Breschdling/HEMAC/MCU/HEMAC_MCU_BOM.ods

Id | Designator | Quantity | Designation | Package
3 | J201 | 1 | Connector angled, maleDIN41612_2x32_B | DIN41612_B_2x32_Horizontal
4 | M101 | 1 | Eurocard_Handle | EuroCard_Handle
5 | U601,U303 | 2 | PCA9515 | SOIC-8_3.9x4.9mm_P1.27mm
6 | D302,D303,D301 | 3 | LED | LED_D3.0mm
7 | X701 | 1 | Raspberry PI model 4 | raspberrypi4
8 | FB101,FB102 | 2 | Ferrite bead 100R, 1210, SMD | FB_1210_3225Metric_Pad1.42x2.65mm_HandSolder
9 | L201,L701 | 2 | Inductor 120uH_3A THT 16mm | 16mm_Radial
10 | SW701 | 1 | Tactile switch_90_Degeree | SW_Tactile_SPST_Angled_PTS645Vx58-2LFS
11 | U301 | 1 | Logic IC 74HC14D SOIC 14 | SOIC-14_3.9x8.7mm_P1.27mm
12 | U401,U501,U502 | 3 | Logic IC 74HC245 SOIC 20W | SOIC-20W_7.5x12.8mm_P1.27mm
13 | C101 | 1 | Capacitor 1nF 1kV 1210, SMD | C_1210
14 | C201,C207,C301,C302,C303,C401,C501,C502,C601,C706,C712 | 11 | Capacitor 100nF 50V 0805 SMD | C_0805
15 | C202,C203,C204,C205,C206,C208,C209,C210,C211,C212,C701,C702,C703,C704,C705,C707,C708,C709,C710,C711 | 20 | Capacitor 10uF 16V 0805 SMD | C_0805
16 | Q601 | 1 | Mosfet 2N7002, SOT-23 SMD | SOT-23
17 | R101,R102,R701,R702,R703,R704 | 6 | Resistor 1210 0R | R_1210
18 | R103 | 1 | Resistor 1210 1M | R_1210
19 | R201,R202,R203,R204,R205,R206,R207,R208,R209,R210,R211,R212,R213,R214,R215,R216,R217,R218,R219,R220,R221,R222,R223,R224,R225,R226,R227,R228,R229,R230,R231,R232,R233,R234,R235,R236,R237,R604,R705 | 39 | Resistor 0805 1% 100R | R_0805
20 | R301,R302,R306 | 3 | Resistor 0805 1% 0R | R_0805
21 | R303,R304,R305 | 3 | Resistor 0805 1% 220R | R_0805
22 | R307,R308,R309,R310 | 4 | Resistor 0805 1% 3k9 | R_0805
23 | R401,R402,R501,R502,R503,R504 | 6 | Resistor 0805 1% 1k | R_0805
24 | R601,R602,R606,R607 | 4 | Resistor 0805 1% 1k8 | R_0805
25 | R603,R605 | 2 | Resistor 0805 1% 4k7 | R_0805
26 | U302 | 1 | EEPROM IC CAT24C32 SOIC 8 | SOIC-8_3.9x4.9mm_P1.27mm
