Breschdling/HEMAC/MCU/Design/HEMAC_MCU_PCB_0.1.pdf

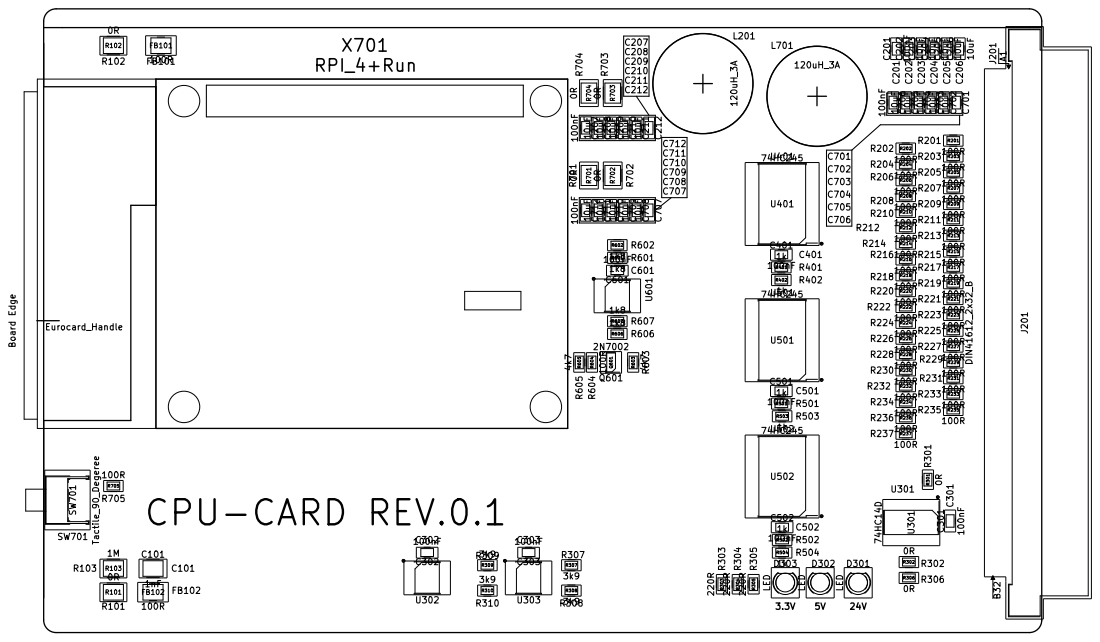
[picture p1: page 1]
