Breschdling/HEMAC/Power/Design/HEMAC_POWER_SCH_0.1.pdf

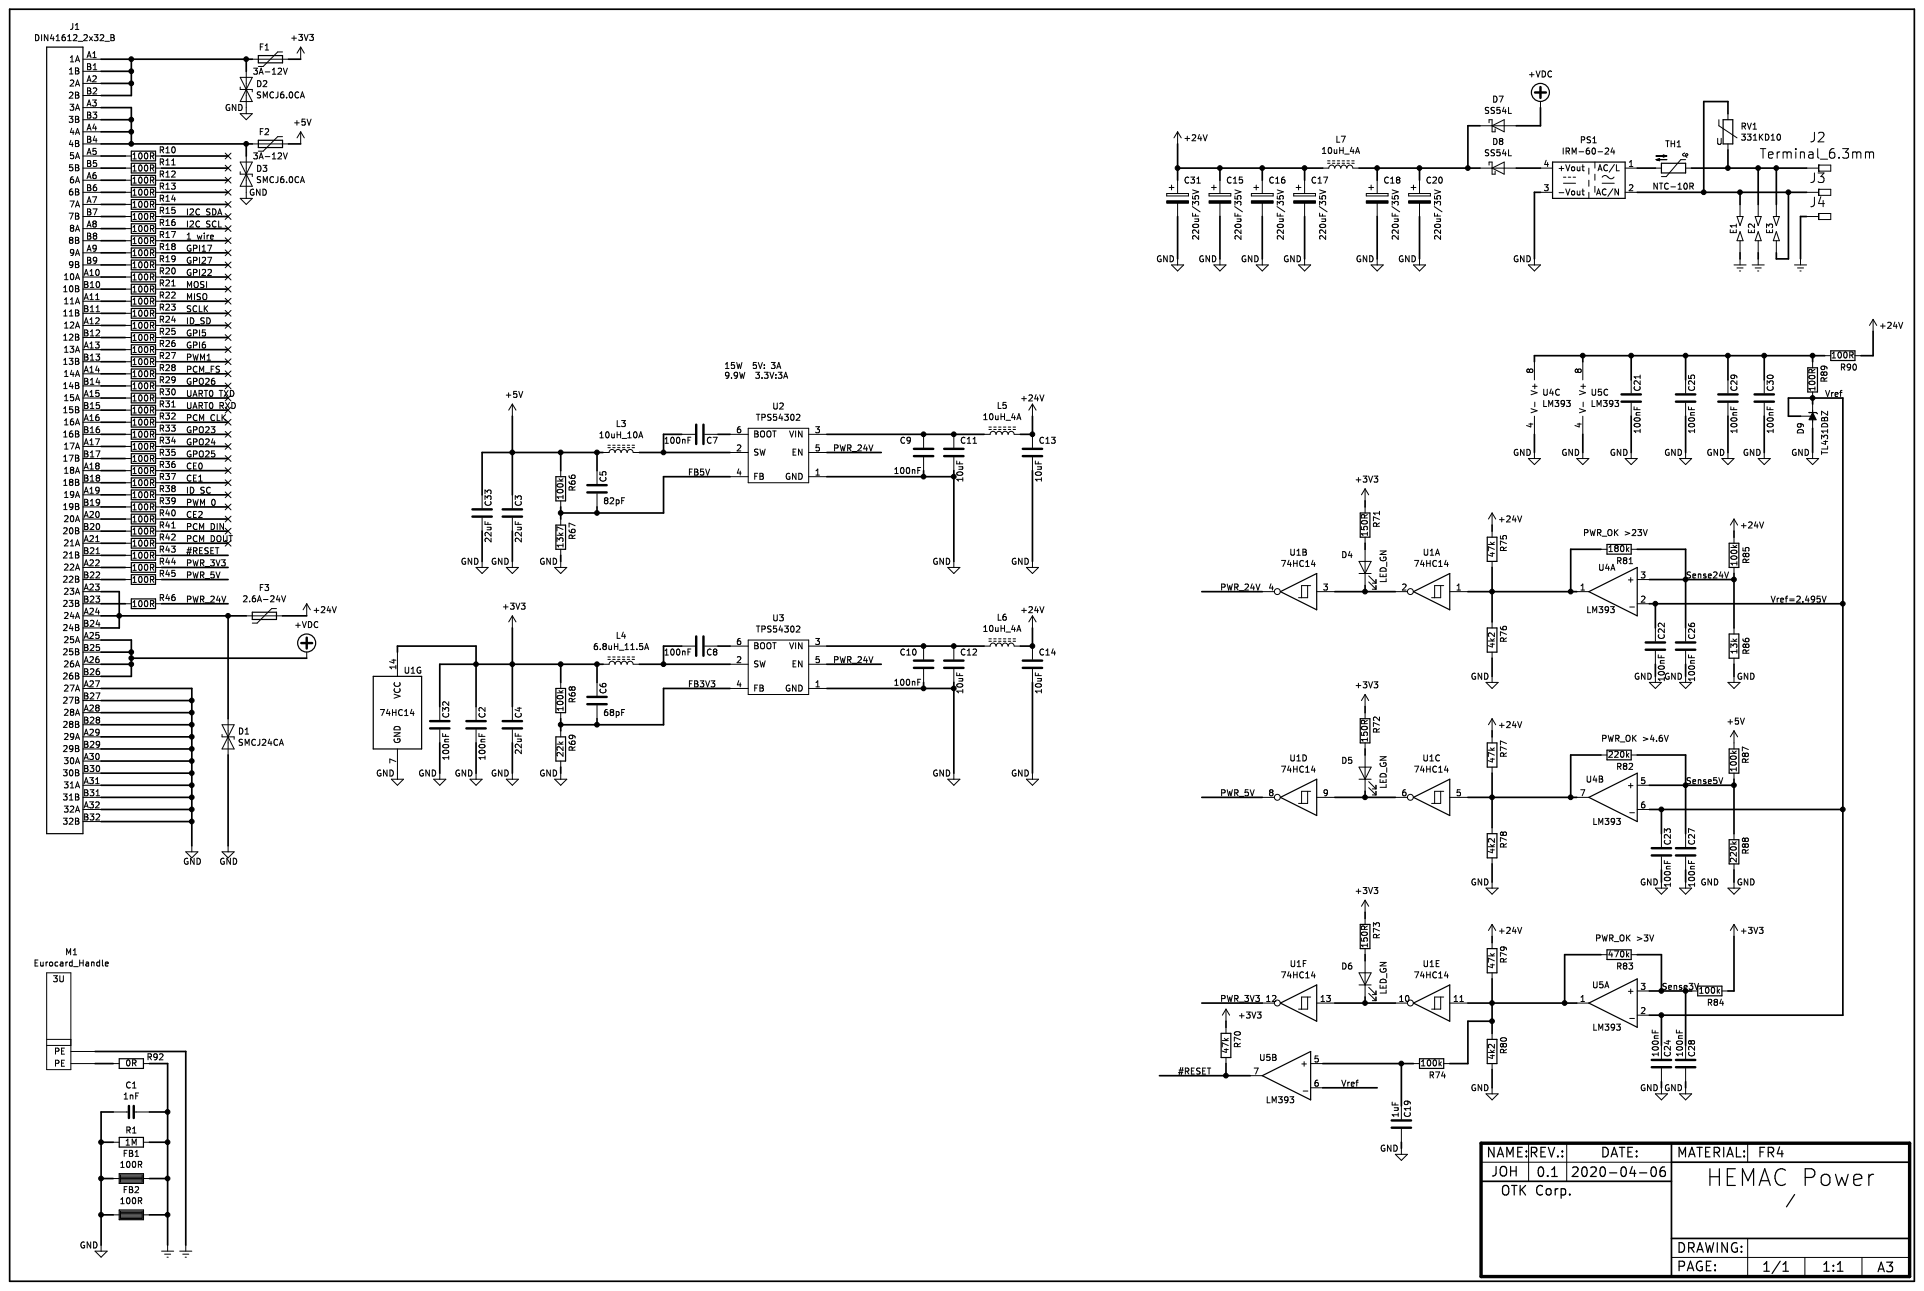
[picture p9: page 1]
