Breschdling/HEMAC/Power/Gerber/PrintPlacement.pdf

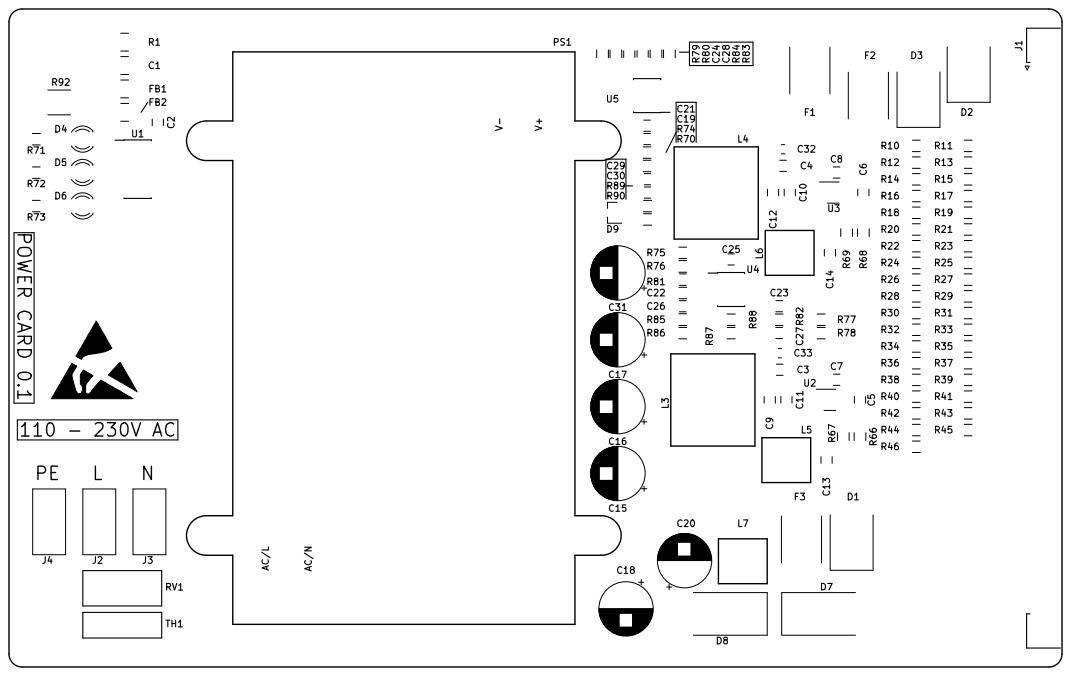
[picture p10: page 1]
