Breschdling/HEMAC/Display/SCH-HEMAC-DISP.pdf

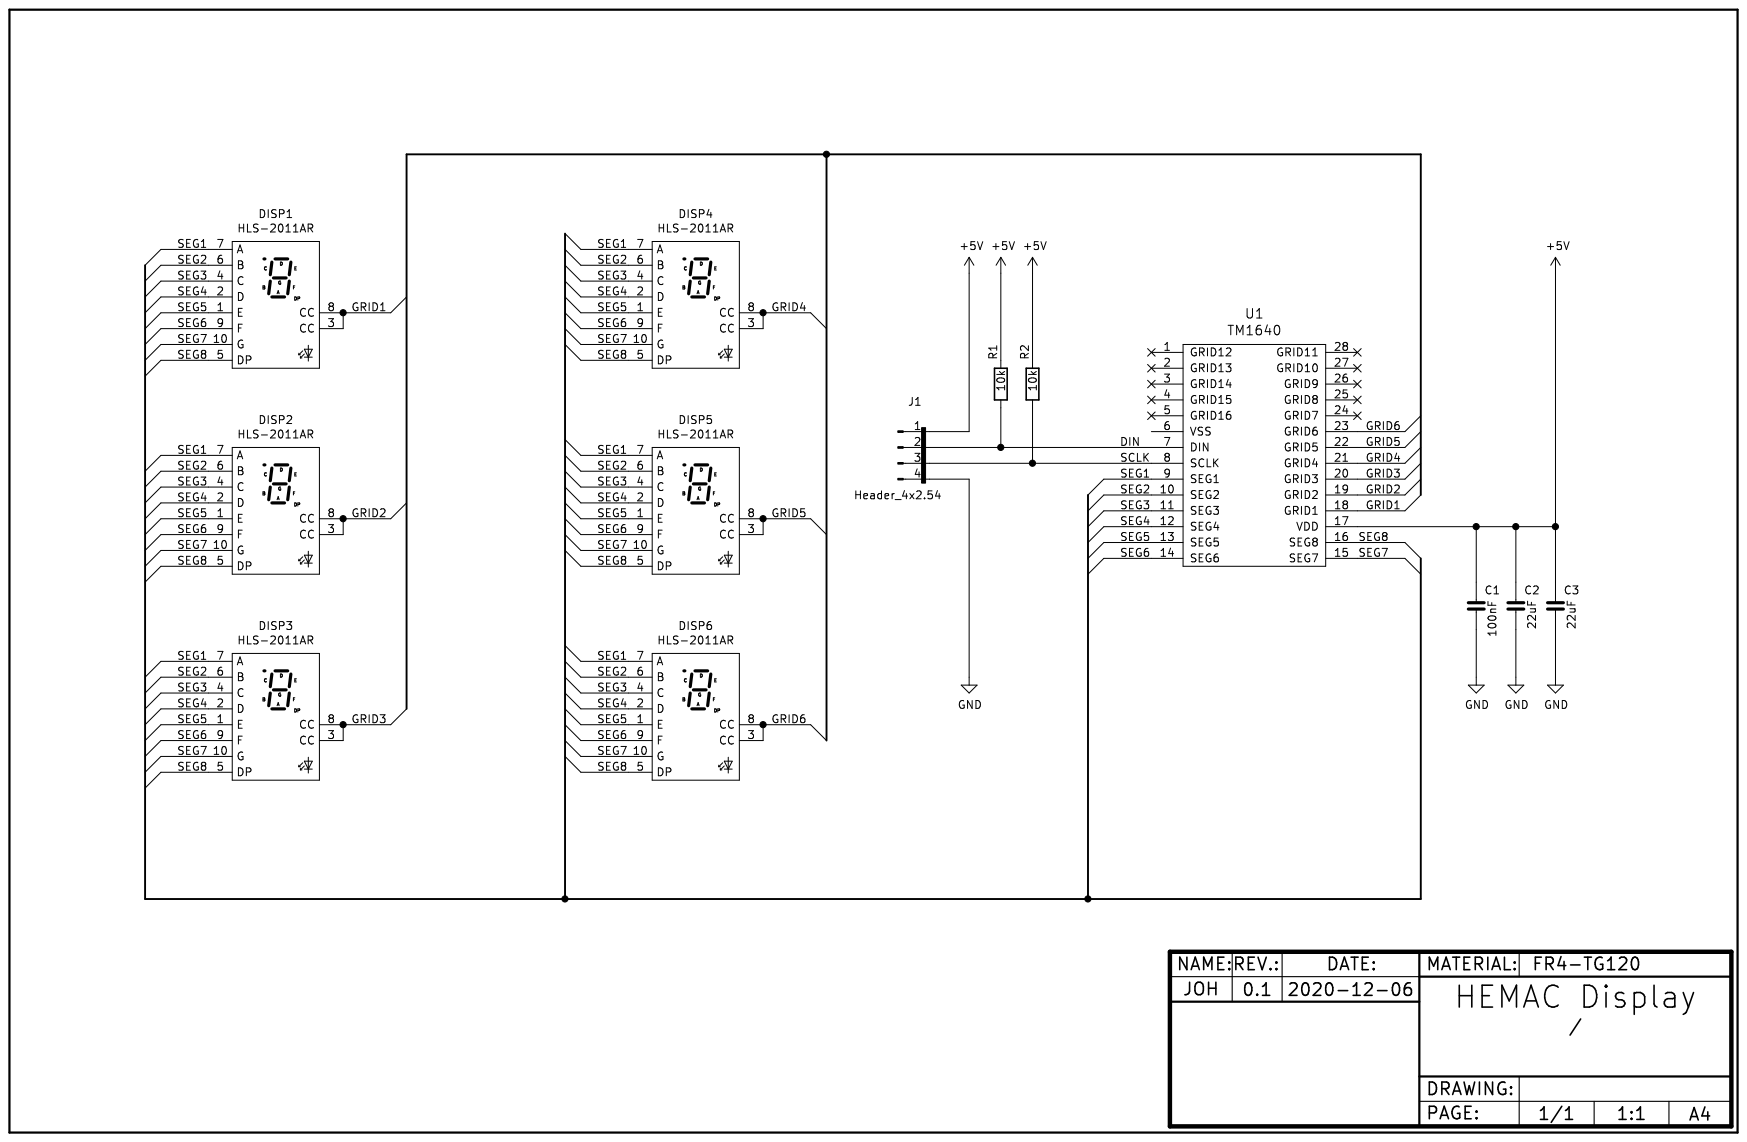
[picture p11: page 1]
