Breschdling/HEMAC/(list of files, drawings)

Other design files:
Display/HEMAC_DISP2.dsn
MCU/HEMAC_MCU.dsn
MCU/HEMAC_MCU_design1.dsn
MCU/HEMAC_MCU_design2.dsn
MCU/HEMAC_MCU_design3.dsn
Power/HEMAC_POWER.dsn
