Breschdling/HEMAC/Display/HEMAC_DISP.kicad_pcb

## KiCad design Display/HEMAC_DISP.kicad_pcb (2023-01-20)

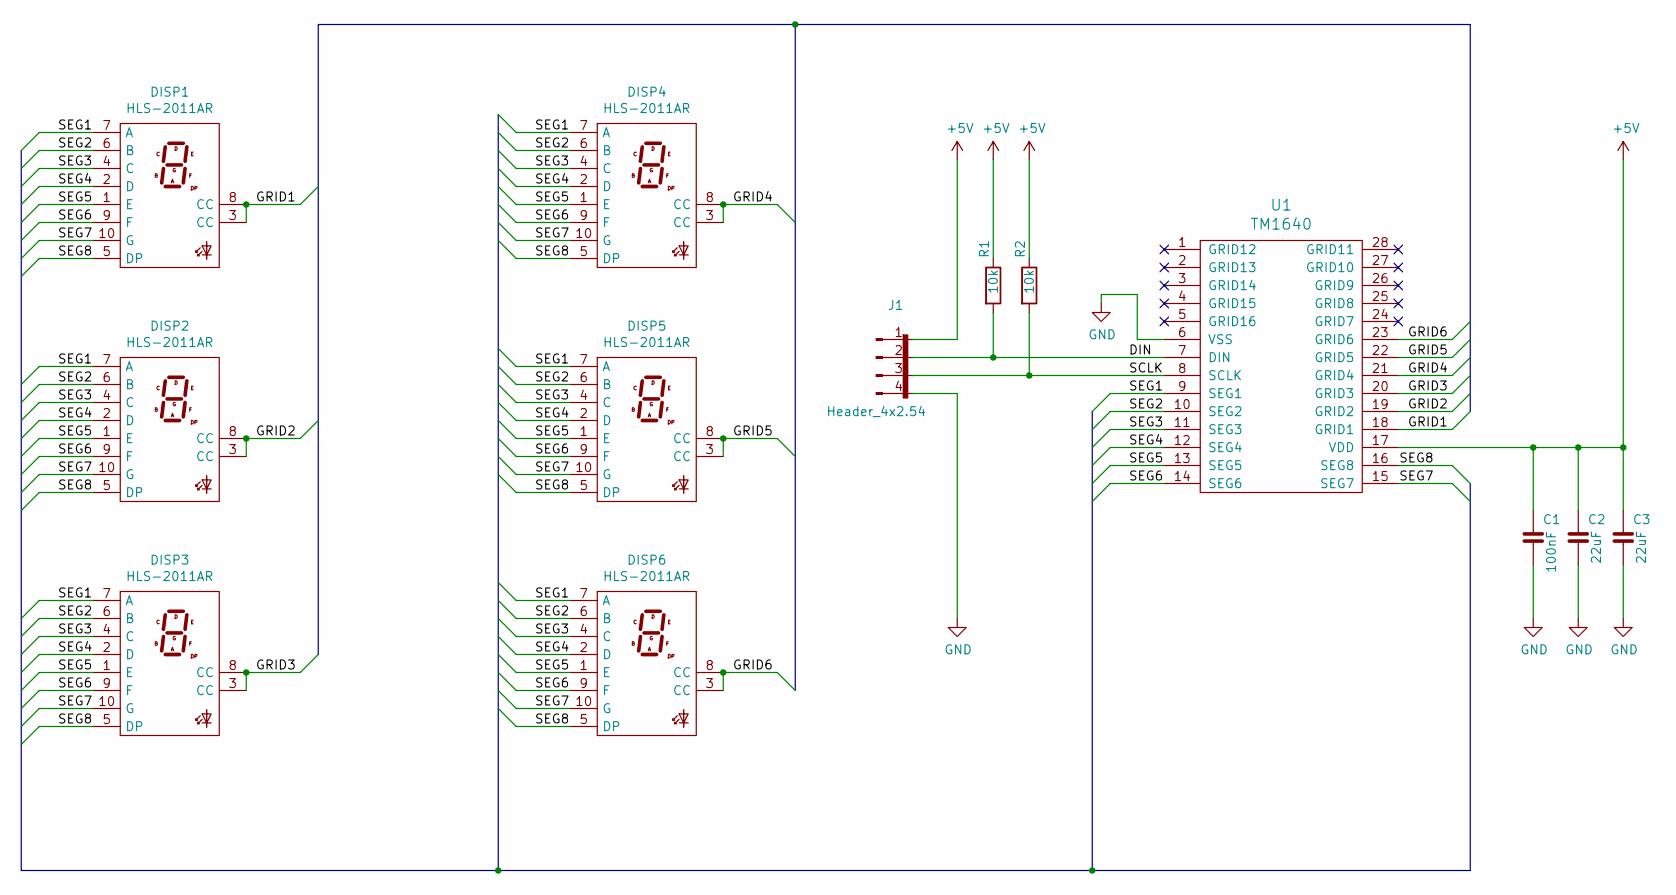
[picture p12: schematic HEMAC_DISP.sch, HEMAC Display]

Parts:
C1: 100nF; C_0805
C2, C3: 22uF; C_0805
DISP1, DISP2, DISP3, DISP4, DISP5, DISP6: HLS-2011AR; HLS-2011_Via
J1: Header_4x2.54; PinHeader_1x04_P2.54mm_Vertical
R1, R2: 10k; R_0805
U1: TM1640; SOIC28P127_1740X1015X255L60X40M

Connections:
+5V: C1.1, C2.1, C3.1, J1.1, R1.1, R2.1, U1.17 (VDD)
/DIN: J1.2, R1.2, U1.7 (DIN)
/GRID1: DISP1.3 (CC), DISP1.8 (CC), U1.18 (GRID1)
/GRID2: DISP2.3 (CC), DISP2.8 (CC), U1.19 (GRID2)
/GRID3: DISP3.3 (CC), DISP3.8 (CC), U1.20 (GRID3)
/GRID4: DISP4.3 (CC), DISP4.8 (CC), U1.21 (GRID4)
/GRID5: DISP5.3 (CC), DISP5.8 (CC), U1.22 (GRID5)
/GRID6: DISP6.3 (CC), DISP6.8 (CC), U1.23 (GRID6)
/SCLK: J1.3, R2.2, U1.8 (SCLK)
/SEG1: DISP1.7 (A), DISP2.7 (A), DISP3.7 (A), DISP4.7 (A), DISP5.7 (A), DISP6.7 (A), U1.9 (SEG1)
/SEG2: DISP1.6 (B), DISP2.6 (B), DISP3.6 (B), DISP4.6 (B), DISP5.6 (B), DISP6.6 (B), U1.10 (SEG2)
/SEG3: DISP1.4 (C), DISP2.4 (C), DISP3.4 (C), DISP4.4 (C), DISP5.4 (C), DISP6.4 (C), U1.11 (SEG3)
/SEG4: DISP1.2 (D), DISP2.2 (D), DISP3.2 (D), DISP4.2 (D), DISP5.2 (D), DISP6.2 (D), U1.12 (SEG4)
/SEG5: DISP1.1 (E), DISP2.1 (E), DISP3.1 (E), DISP4.1 (E), DISP5.1 (E), DISP6.1 (E), U1.13 (SEG5)
/SEG6: DISP1.9 (F), DISP2.9 (F), DISP3.9 (F), DISP4.9 (F), DISP5.9 (F), DISP6.9 (F), U1.14 (SEG6)
/SEG7: DISP1.10 (G), DISP2.10 (G), DISP3.10 (G), DISP4.10 (G), DISP5.10 (G), DISP6.10 (G), U1.15 (SEG7)
/SEG8: DISP1.5 (DP), DISP2.5 (DP), DISP3.5 (DP), DISP4.5 (DP), DISP5.5 (DP), DISP6.5 (DP), U1.16 (SEG8)
GND: C1.2, C2.2, C3.2, J1.4, U1.6 (VSS)

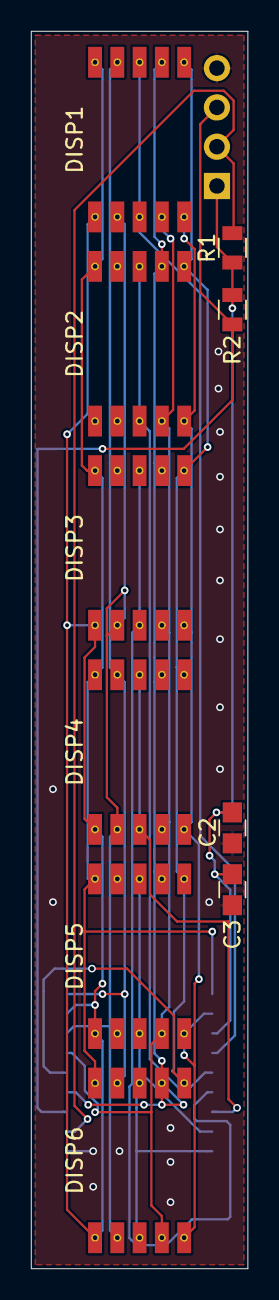
[picture p13: board HEMAC_DISP.kicad_pcb from above]

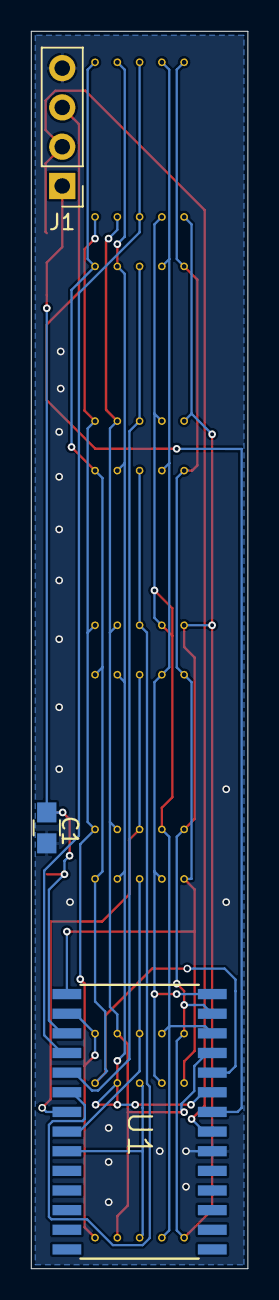
[picture p14: board HEMAC_DISP.kicad_pcb from below]

Board: 2 copper layers, 14.0 x 80.0 mm, 13 parts (3 on the bottom side), 18 nets.
