Breschdling/HEMAC/Backplane/HEMAC_Backplane.kicad_pcb

## KiCad design Backplane/HEMAC_Backplane.kicad_pcb (2023-01-20)

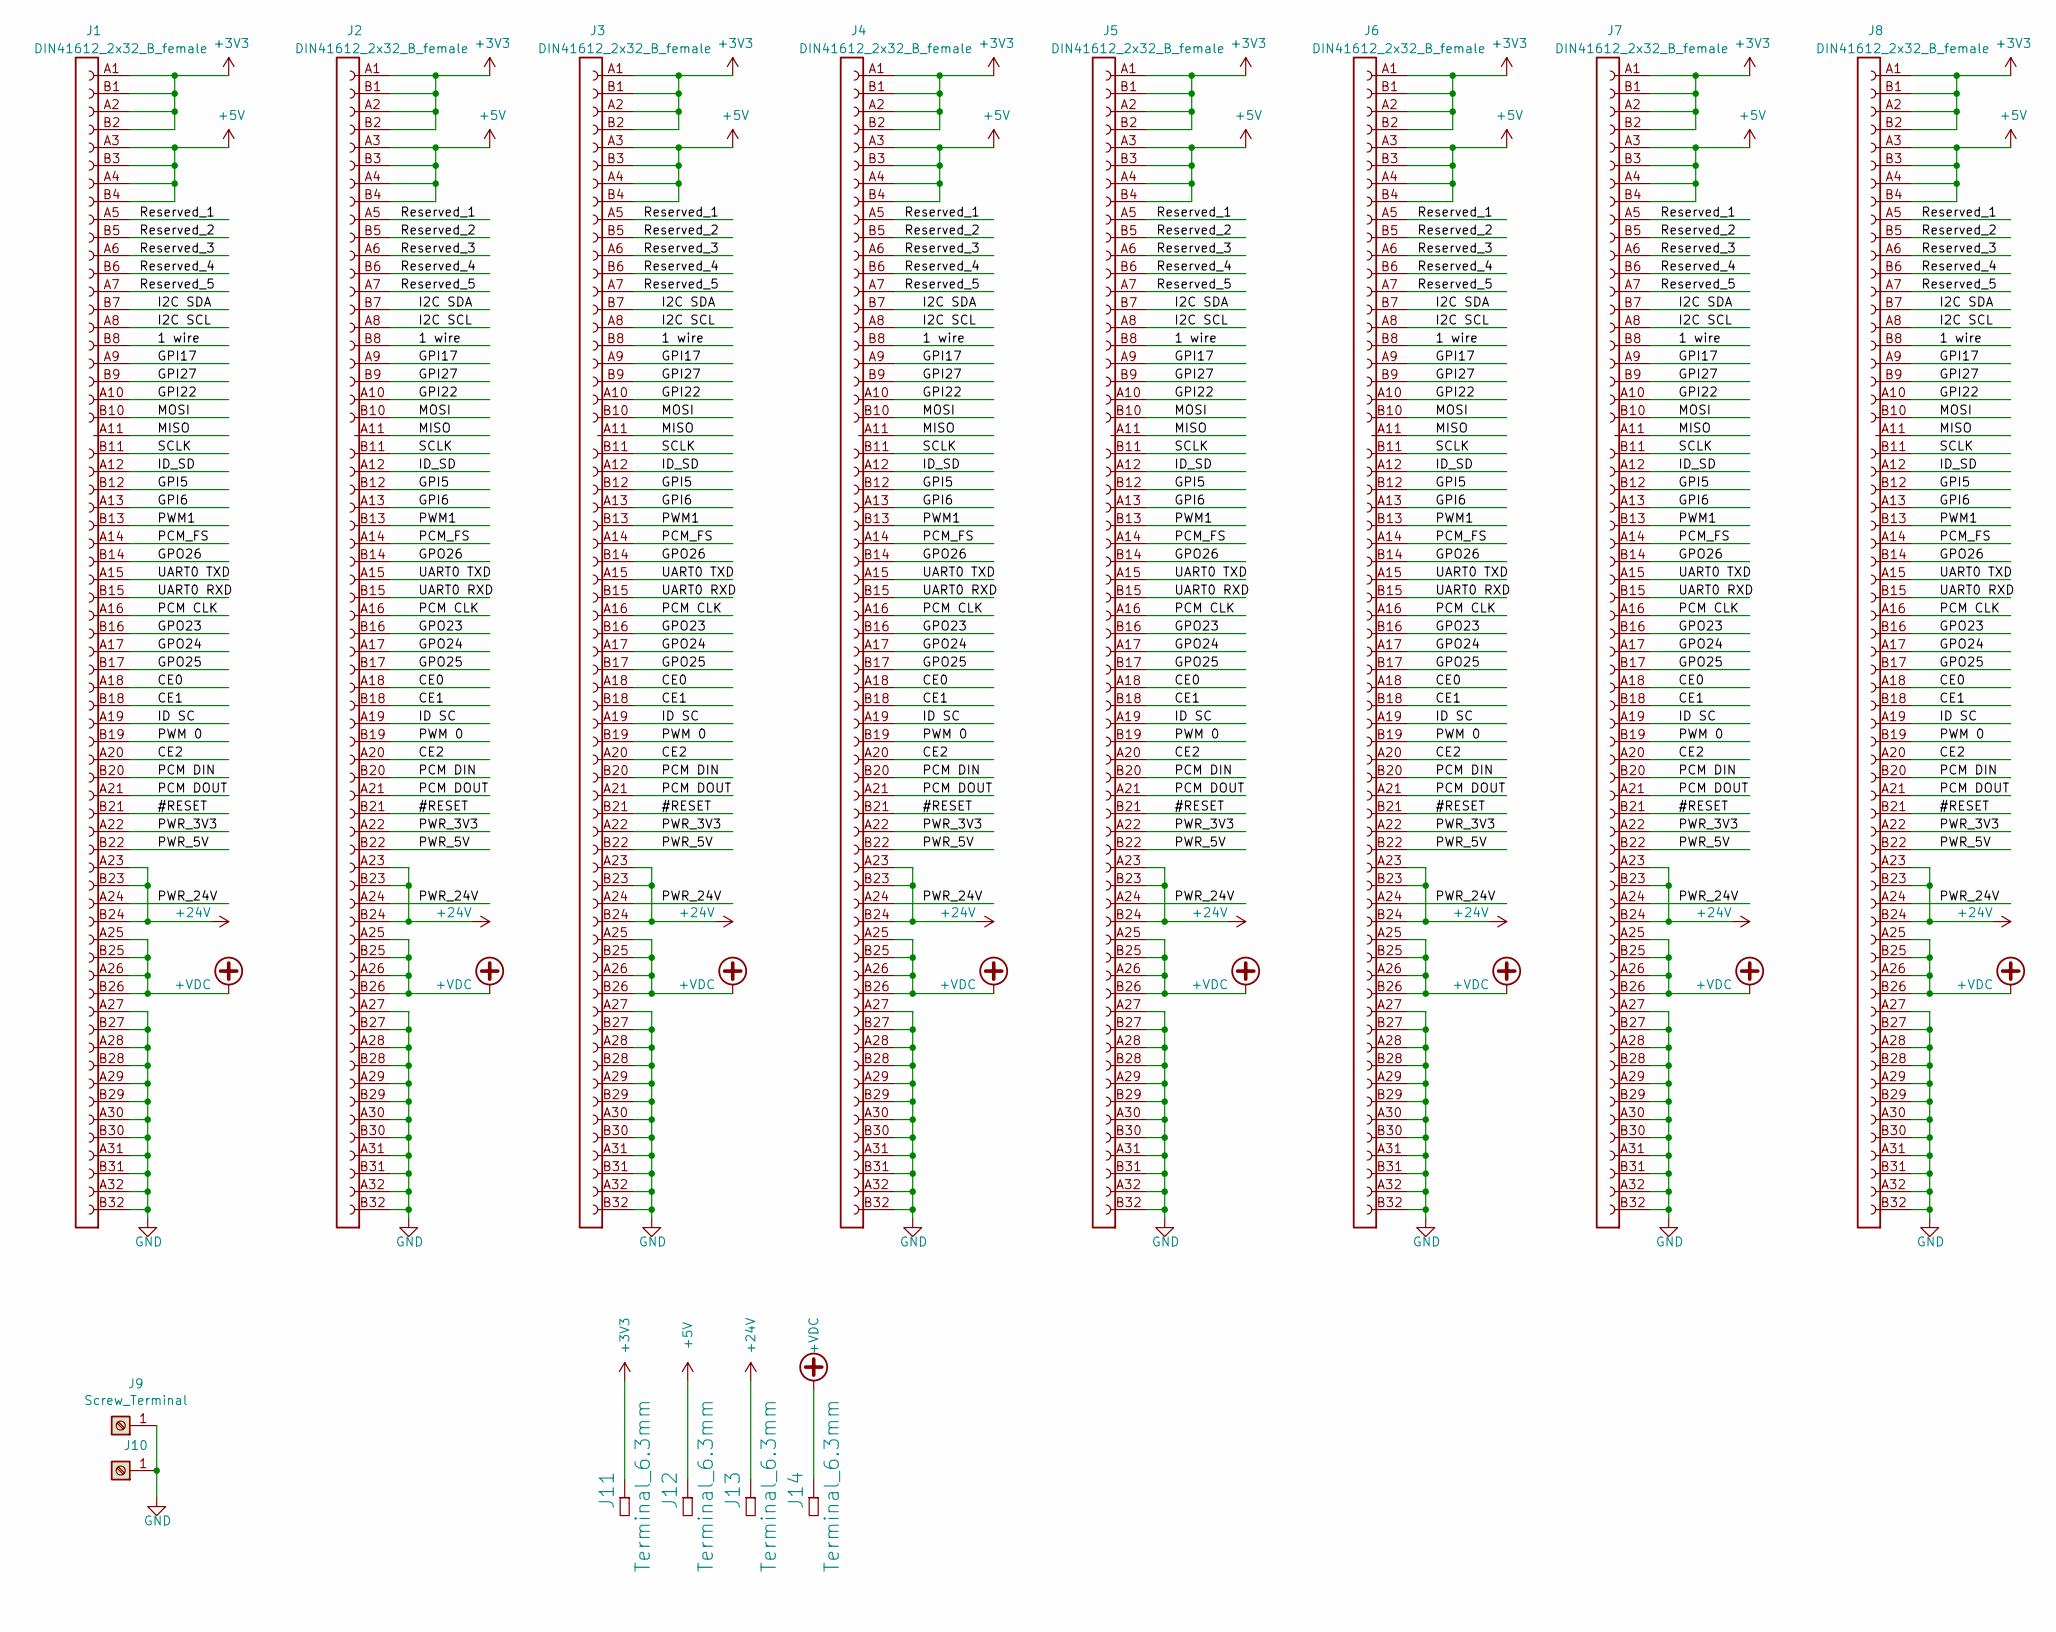
[picture p15: schematic Bus.sch]

Parts:
J1, J2, J3, J4, J5, J6, J7, J8: DIN41612_2x32_B_female; DIN41612_B_2x32_Vertical
J9, J10: Screw_Terminal; GD-G13
J11, J12, J13, J14: Terminal_6.3mm; Terminal_6.3mm_THT

Connections:
+3V3: J1.A1 (1A), J1.A2 (2A), J1.B1 (1B), J1.B2 (2B), J2.A1 (1A), J2.A2 (2A), J2.B1 (1B), J2.B2 (2B), J3.A1 (1A), J3.A2 (2A), J3.B1 (1B), J3.B2 (2B), J4.A1 (1A), J4.A2 (2A), J4.B1 (1B), J4.B2 (2B), J5.A1 (1A), J5.A2 (2A), J5.B1 (1B), J5.B2 (2B), J6.A1 (1A), J6.A2 (2A), J6.B1 (1B), J6.B2 (2B), J7.A1 (1A), J7.A2 (2A), J7.B1 (1B), J7.B2 (2B), J8.A1 (1A), J8.A2 (2A), J8.B1 (1B), J8.B2 (2B), J11.1
+5V: J1.A3 (3A), J1.A4 (4A), J1.B3 (3B), J1.B4 (4B), J2.A3 (3A), J2.A4 (4A), J2.B3 (3B), J2.B4 (4B), J3.A3 (3A), J3.A4 (4A), J3.B3 (3B), J3.B4 (4B), J4.A3 (3A), J4.A4 (4A), J4.B3 (3B), J4.B4 (4B), J5.A3 (3A), J5.A4 (4A), J5.B3 (3B), J5.B4 (4B), J6.A3 (3A), J6.A4 (4A), J6.B3 (3B), J6.B4 (4B), J7.A3 (3A), J7.A4 (4A), J7.B3 (3B), J7.B4 (4B), J8.A3 (3A), J8.A4 (4A), J8.B3 (3B), J8.B4 (4B), J12.1
+24V: J1.A23 (23A), J1.B23 (23B), J1.B24 (24B), J2.A23 (23A), J2.B23 (23B), J2.B24 (24B), J3.A23 (23A), J3.B23 (23B), J3.B24 (24B), J4.A23 (23A), J4.B23 (23B), J4.B24 (24B), J5.A23 (23A), J5.B23 (23B), J5.B24 (24B), J6.A23 (23A), J6.B23 (23B), J6.B24 (24B), J7.A23 (23A), J7.B23 (23B), J7.B24 (24B), J8.A23 (23A), J8.B23 (23B), J8.B24 (24B), J13.1
/Bus/1 wire: J1.B8 (8B), J2.B8 (8B), J3.B8 (8B), J4.B8 (8B), J5.B8 (8B), J6.B8 (8B), J7.B8 (8B), J8.B8 (8B)
/Bus/#RESET: J1.B21 (21B), J2.B21 (21B), J3.B21 (21B), J4.B21 (21B), J5.B21 (21B), J6.B21 (21B), J7.B21 (21B), J8.B21 (21B)
/Bus/CE0: J1.A18 (18A), J2.A18 (18A), J3.A18 (18A), J4.A18 (18A), J5.A18 (18A), J6.A18 (18A), J7.A18 (18A), J8.A18 (18A)
/Bus/CE1: J1.B18 (18B), J2.B18 (18B), J3.B18 (18B), J4.B18 (18B), J5.B18 (18B), J6.B18 (18B), J7.B18 (18B), J8.B18 (18B)
/Bus/CE2: J1.A20 (20A), J2.A20 (20A), J3.A20 (20A), J4.A20 (20A), J5.A20 (20A), J6.A20 (20A), J7.A20 (20A), J8.A20 (20A)
/Bus/GPI5: J1.B12 (12B), J2.B12 (12B), J3.B12 (12B), J4.B12 (12B), J5.B12 (12B), J6.B12 (12B), J7.B12 (12B), J8.B12 (12B)
/Bus/GPI6: J1.A13 (13A), J2.A13 (13A), J3.A13 (13A), J4.A13 (13A), J5.A13 (13A), J6.A13 (13A), J7.A13 (13A), J8.A13 (13A)
/Bus/GPI17: J1.A9 (9A), J2.A9 (9A), J3.A9 (9A), J4.A9 (9A), J5.A9 (9A), J6.A9 (9A), J7.A9 (9A), J8.A9 (9A)
/Bus/GPI22: J1.A10 (10A), J2.A10 (10A), J3.A10 (10A), J4.A10 (10A), J5.A10 (10A), J6.A10 (10A), J7.A10 (10A), J8.A10 (10A)
/Bus/GPI27: J1.B9 (9B), J2.B9 (9B), J3.B9 (9B), J4.B9 (9B), J5.B9 (9B), J6.B9 (9B), J7.B9 (9B), J8.B9 (9B)
/Bus/GPO23: J1.B16 (16B), J2.B16 (16B), J3.B16 (16B), J4.B16 (16B), J5.B16 (16B), J6.B16 (16B), J7.B16 (16B), J8.B16 (16B)
/Bus/GPO24: J1.A17 (17A), J2.A17 (17A), J3.A17 (17A), J4.A17 (17A), J5.A17 (17A), J6.A17 (17A), J7.A17 (17A), J8.A17 (17A)
/Bus/GPO25: J1.B17 (17B), J2.B17 (17B), J3.B17 (17B), J4.B17 (17B), J5.B17 (17B), J6.B17 (17B), J7.B17 (17B), J8.B17 (17B)
/Bus/GPO26: J1.B14 (14B), J2.B14 (14B), J3.B14 (14B), J4.B14 (14B), J5.B14 (14B), J6.B14 (14B), J7.B14 (14B), J8.B14 (14B)
/Bus/I2C SCL: J1.A8 (8A), J2.A8 (8A), J3.A8 (8A), J4.A8 (8A), J5.A8 (8A), J6.A8 (8A), J7.A8 (8A), J8.A8 (8A)
/Bus/I2C SDA: J1.B7 (7B), J2.B7 (7B), J3.B7 (7B), J4.B7 (7B), J5.B7 (7B), J6.B7 (7B), J7.B7 (7B), J8.B7 (7B)
/Bus/ID SC: J1.A19 (19A), J2.A19 (19A), J3.A19 (19A), J4.A19 (19A), J5.A19 (19A), J6.A19 (19A), J7.A19 (19A), J8.A19 (19A)
/Bus/ID_SD: J1.A12 (12A), J2.A12 (12A), J3.A12 (12A), J4.A12 (12A), J5.A12 (12A), J6.A12 (12A), J7.A12 (12A), J8.A12 (12A)
/Bus/MISO: J1.A11 (11A), J2.A11 (11A), J3.A11 (11A), J4.A11 (11A), J5.A11 (11A), J6.A11 (11A), J7.A11 (11A), J8.A11 (11A)
/Bus/MOSI: J1.B10 (10B), J2.B10 (10B), J3.B10 (10B), J4.B10 (10B), J5.B10 (10B), J6.B10 (10B), J7.B10 (10B), J8.B10 (10B)
/Bus/PCM CLK: J1.A16 (16A), J2.A16 (16A), J3.A16 (16A), J4.A16 (16A), J5.A16 (16A), J6.A16 (16A), J7.A16 (16A), J8.A16 (16A)
/Bus/PCM DIN: J1.B20 (20B), J2.B20 (20B), J3.B20 (20B), J4.B20 (20B), J5.B20 (20B), J6.B20 (20B), J7.B20 (20B), J8.B20 (20B)
/Bus/PCM DOUT: J1.A21 (21A), J2.A21 (21A), J3.A21 (21A), J4.A21 (21A), J5.A21 (21A), J6.A21 (21A), J7.A21 (21A), J8.A21 (21A)
/Bus/PCM_FS: J1.A14 (14A), J2.A14 (14A), J3.A14 (14A), J4.A14 (14A), J5.A14 (14A), J6.A14 (14A), J7.A14 (14A), J8.A14 (14A)
/Bus/PWM1: J1.B13 (13B), J2.B13 (13B), J3.B13 (13B), J4.B13 (13B), J5.B13 (13B), J6.B13 (13B), J7.B13 (13B), J8.B13 (13B)
/Bus/PWM 0: J1.B19 (19B), J2.B19 (19B), J3.B19 (19B), J4.B19 (19B), J5.B19 (19B), J6.B19 (19B), J7.B19 (19B), J8.B19 (19B)
/Bus/PWR_3V3: J1.A22 (22A), J2.A22 (22A), J3.A22 (22A), J4.A22 (22A), J5.A22 (22A), J6.A22 (22A), J7.A22 (22A), J8.A22 (22A)
/Bus/PWR_5V: J1.B22 (22B), J2.B22 (22B), J3.B22 (22B), J4.B22 (22B), J5.B22 (22B), J6.B22 (22B), J7.B22 (22B), J8.B22 (22B)
/Bus/PWR_24V: J1.A24 (24A), J2.A24 (24A), J3.A24 (24A), J4.A24 (24A), J5.A24 (24A), J6.A24 (24A), J7.A24 (24A), J8.A24 (24A)
/Bus/Reserved_1: J1.A5 (5A), J2.A5 (5A), J3.A5 (5A), J4.A5 (5A), J5.A5 (5A), J6.A5 (5A), J7.A5 (5A), J8.A5 (5A)
/Bus/Reserved_2: J1.B5 (5B), J2.B5 (5B), J3.B5 (5B), J4.B5 (5B), J5.B5 (5B), J6.B5 (5B), J7.B5 (5B), J8.B5 (5B)
/Bus/Reserved_3: J1.A6 (6A), J2.A6 (6A), J3.A6 (6A), J4.A6 (6A), J5.A6 (6A), J6.A6 (6A), J7.A6 (6A), J8.A6 (6A)
/Bus/Reserved_4: J1.B6 (6B), J2.B6 (6B), J3.B6 (6B), J4.B6 (6B), J5.B6 (6B), J6.B6 (6B), J7.B6 (6B), J8.B6 (6B)
/Bus/Reserved_5: J1.A7 (7A), J2.A7 (7A), J3.A7 (7A), J4.A7 (7A), J5.A7 (7A), J6.A7 (7A), J7.A7 (7A), J8.A7 (7A)
/Bus/SCLK: J1.B11 (11B), J2.B11 (11B), J3.B11 (11B), J4.B11 (11B), J5.B11 (11B), J6.B11 (11B), J7.B11 (11B), J8.B11 (11B)
/Bus/UART0 RXD: J1.B15 (15B), J2.B15 (15B), J3.B15 (15B), J4.B15 (15B), J5.B15 (15B), J6.B15 (15B), J7.B15 (15B), J8.B15 (15B)
/Bus/UART0 TXD: J1.A15 (15A), J2.A15 (15A), J3.A15 (15A), J4.A15 (15A), J5.A15 (15A), J6.A15 (15A), J7.A15 (15A), J8.A15 (15A)
GND: J1.A27 (27A), J1.A28 (28A), J1.A29 (29A), J1.A30 (30A), J1.A31 (31A), J1.A32 (32A), J1.B27 (27B), J1.B28 (28B), J1.B29 (29B), J1.B30 (30B), J1.B31 (31B), J1.B32 (32B), J2.A27 (27A), J2.A28 (28A), J2.A29 (29A), J2.A30 (30A), J2.A31 (31A), J2.A32 (32A), J2.B27 (27B), J2.B28 (28B), J2.B29 (29B), J2.B30 (30B), J2.B31 (31B), J2.B32 (32B), J3.A27 (27A), J3.A28 (28A), J3.A29 (29A), J3.A30 (30A), J3.A31 (31A), J3.A32 (32A), J3.B27 (27B), J3.B28 (28B), J3.B29 (29B), J3.B30 (30B), J3.B31 (31B), J3.B32 (32B), J4.A27 (27A), J4.A28 (28A), J4.A29 (29A), J4.A30 (30A), J4.A31 (31A), J4.A32 (32A), J4.B27 (27B), J4.B28 (28B), J4.B29 (29B), J4.B30 (30B), J4.B31 (31B), J4.B32 (32B), J5.A27 (27A), J5.A28 (28A), J5.A29 (29A), J5.A30 (30A), J5.A31 (31A), J5.A32 (32A), J5.B27 (27B), J5.B28 (28B), J5.B29 (29B), J5.B30 (30B), J5.B31 (31B), J5.B32 (32B), J6.A27 (27A), J6.A28 (28A), J6.A29 (29A), J6.A30 (30A), J6.A31 (31A), J6.A32 (32A), J6.B27 (27B), J6.B28 (28B), J6.B29 (29B), J6.B30 (30B), J6.B31 (31B), J6.B32 (32B), J7.A27 (27A), J7.A28 (28A), J7.A29 (29A), J7.A30 (30A), J7.A31 (31A), J7.A32 (32A), J7.B27 (27B), J7.B28 (28B), J7.B29 (29B), J7.B30 (30B), J7.B31 (31B), J7.B32 (32B), J8.A27 (27A), J8.A28 (28A), J8.A29 (29A), J8.A30 (30A), J8.A31 (31A), J8.A32 (32A), J8.B27 (27B), J8.B28 (28B), J8.B29 (29B), J8.B30 (30B), J8.B31 (31B), J8.B32 (32B), J9.1, J10.1
VDC: J1.A25 (25A), J1.A26 (26A), J1.B25 (25B), J1.B26 (26B), J2.A25 (25A), J2.A26 (26A), J2.B25 (25B), J2.B26 (26B), J3.A25 (25A), J3.A26 (26A), J3.B25 (25B), J3.B26 (26B), J4.A25 (25A), J4.A26 (26A), J4.B25 (25B), J4.B26 (26B), J5.A25 (25A), J5.A26 (26A), J5.B25 (25B), J5.B26 (26B), J6.A25 (25A), J6.A26 (26A), J6.B25 (25B), J6.B26 (26B), J7.A25 (25A), J7.A26 (26A), J7.B25 (25B), J7.B26 (26B), J8.A25 (25A), J8.A26 (26A), J8.B25 (25B), J8.B26 (26B), J14.1

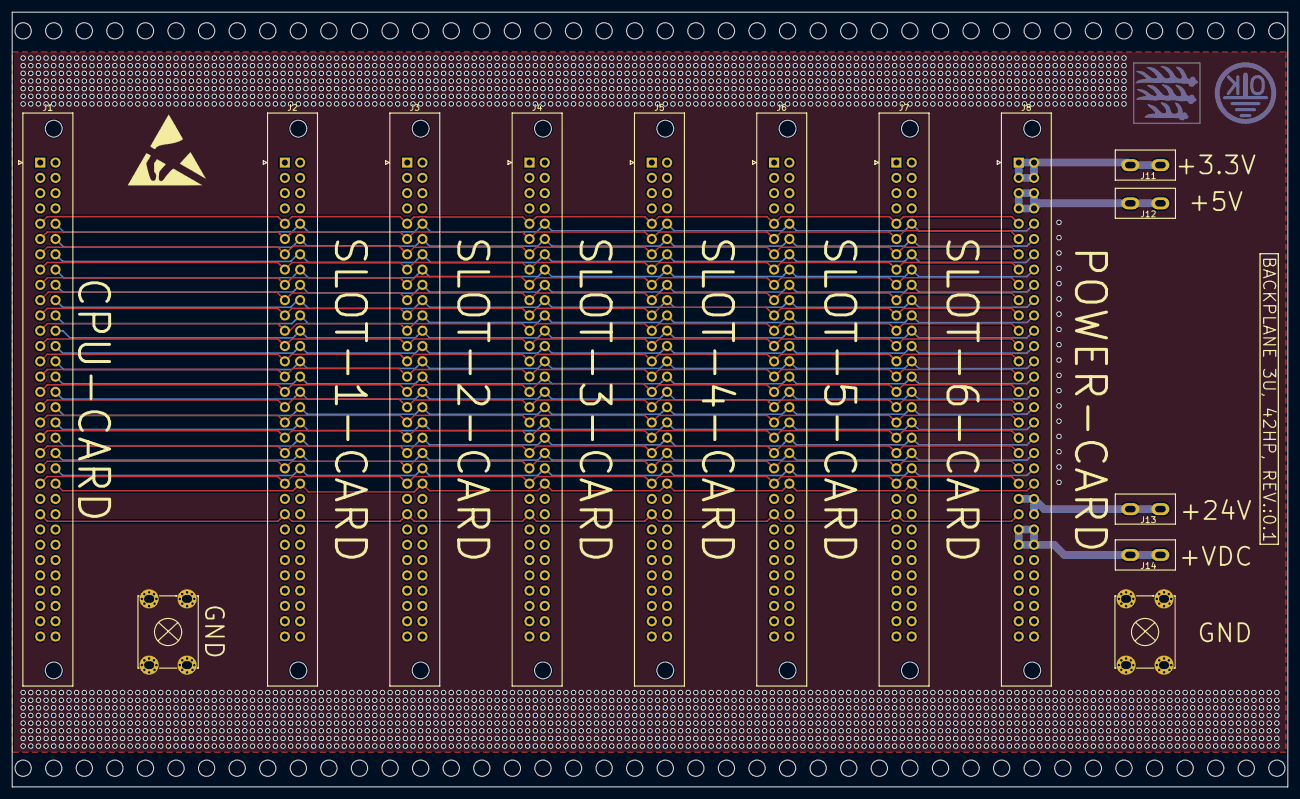
[picture p16: board HEMAC_Backplane.kicad_pcb from above]

Board: 2 copper layers, 211.9 x 128.7 mm, 14 parts (0 on the bottom side), 42 nets.
