Breschdling/HEMAC/MCU/HEMAC_MCU.kicad_pcb

## KiCad design MCU/HEMAC_MCU.kicad_pcb (2023-01-20)

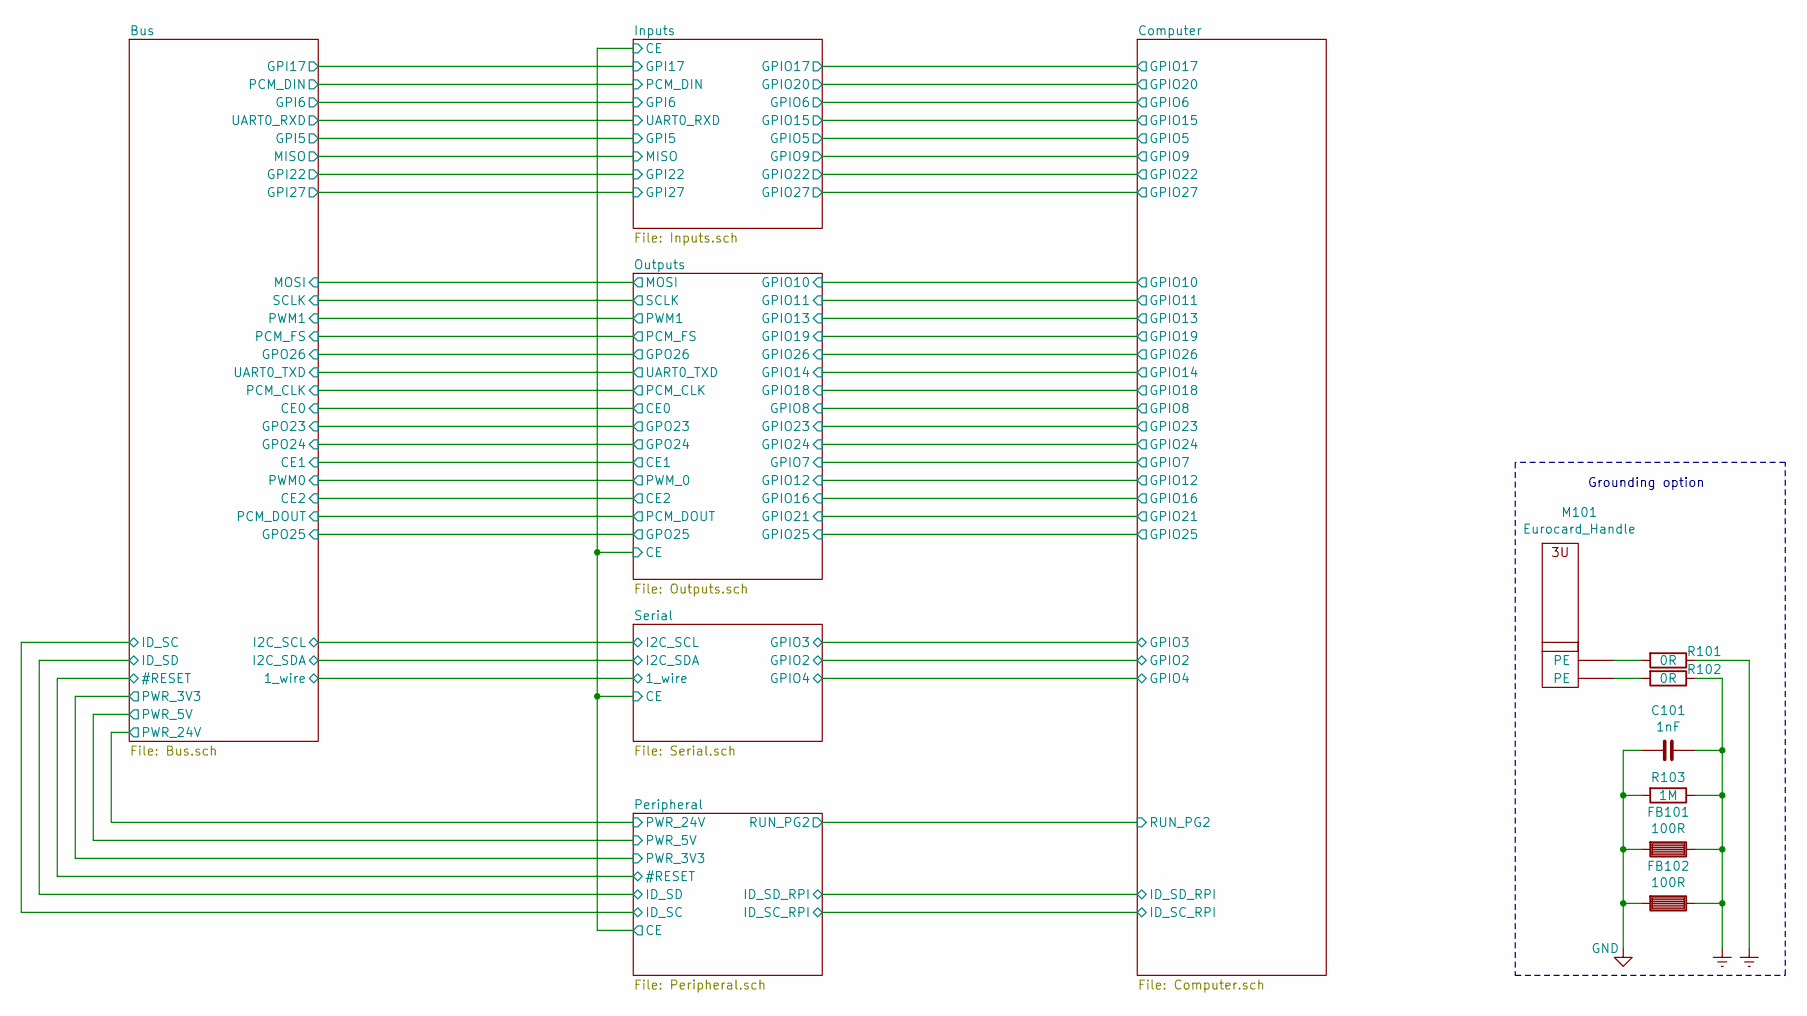
[picture p17: schematic HEMAC_MCU.sch, HEMAC MCU]

Parts:
C101: 1nF; C_1210
FB101, FB102: 100R; FB_1210_3225Metric_Pad1.42x2.65mm_HandSolder
M101: Eurocard_Handle; EuroCard_Handle
R101, R102: 0R; R_1210
R103: 1M; R_1210

Connections:
Earth: C101.1, FB101.1, FB102.1, R101.1, R102.1, R103.1
GND: C101.2, FB101.2, FB102.2, R103.2; also elsewhere on the board
unnamed: M101.1, R101.2
unnamed: M101.2, R102.2

Notes on the sheet:
Grounding option

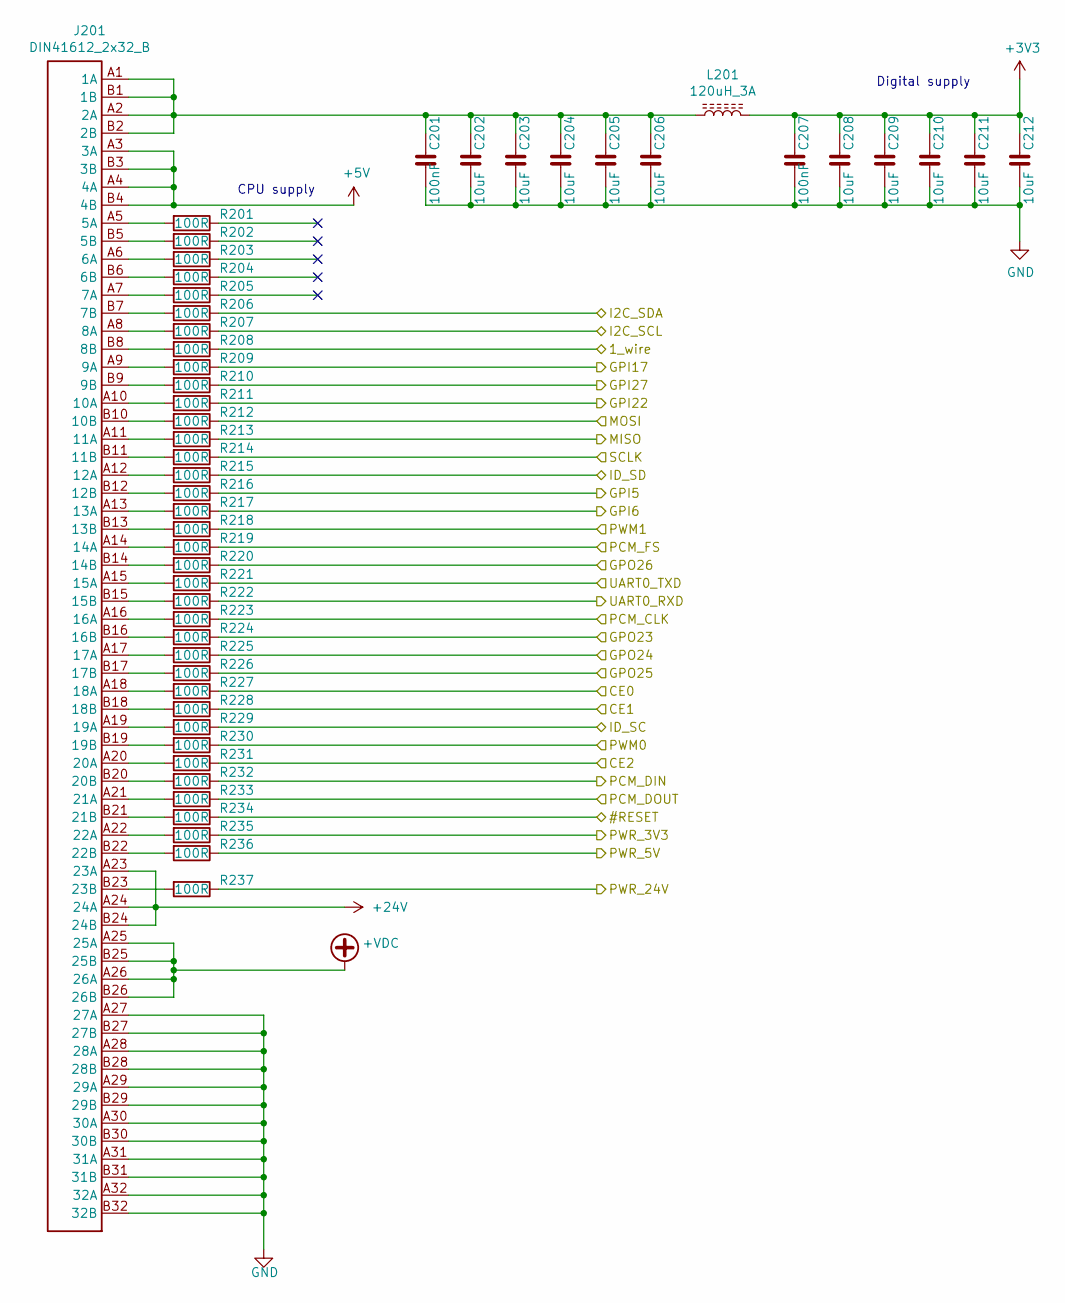
[picture p18: schematic Bus.sch, HEMAC MCU]

Parts:
C201, C207: 100nF; C_0805
C202, C203, C204, C205, C206, C208, C209, C210, C211, C212: 10uF; C_0805
J201: DIN41612_2x32_B; DIN41612_B_2x32_Horizontal
L201: 120uH_3A; 16mm_Radial
R201, R202, R203, R204, R205, R206, R207, R208, R209, R210, R211, R212, R213, R214, R215, R216, R217, R218, R219, R220, R221, R222, R223, R224, R225, R226, R227, R228, R229, R230, R231, R232, R233, R234, R235, R236, R237: 100R; R_0805

Connections:
+3V3: C207.1, C208.1, C209.1, C210.1, C211.1, C212.1, L201.2; also elsewhere on the board
+5V: J201.A3 (3A), J201.A4 (4A), J201.B3 (3B), J201.B4 (4B); also elsewhere on the board
+24V: J201.A23 (23A), J201.A24 (24A), J201.B24 (24B)
/Bus/1_wire: R208.1; also elsewhere on the board
/Bus/#RESET: R234.1; also elsewhere on the board
/Bus/CE0: R227.1; also elsewhere on the board
/Bus/CE1: R228.1; also elsewhere on the board
/Bus/CE2: R231.1; also elsewhere on the board
/Bus/GPI5: R216.1; also elsewhere on the board
/Bus/GPI6: R217.1; also elsewhere on the board
/Bus/GPI17: R209.1; also elsewhere on the board
/Bus/GPI22: R211.1; also elsewhere on the board
/Bus/GPI27: R210.1; also elsewhere on the board
/Bus/GPO23: R224.1; also elsewhere on the board
/Bus/GPO24: R225.1; also elsewhere on the board
/Bus/GPO25: R226.1; also elsewhere on the board
/Bus/GPO26: R220.1; also elsewhere on the board
/Bus/I2C_SCL: R207.1; also elsewhere on the board
/Bus/I2C_SDA: R206.1; also elsewhere on the board
/Bus/ID_SC: R229.1; also elsewhere on the board
/Bus/ID_SD: R215.1; also elsewhere on the board
/Bus/MISO: R213.1; also elsewhere on the board
/Bus/MOSI: R212.1; also elsewhere on the board
/Bus/PCM_CLK: R223.1; also elsewhere on the board
/Bus/PCM_DIN: R232.1; also elsewhere on the board
/Bus/PCM_DOUT: R233.1; also elsewhere on the board
/Bus/PCM_FS: R219.1; also elsewhere on the board
/Bus/PWM0: R230.1; also elsewhere on the board
/Bus/PWM1: R218.1; also elsewhere on the board
/Bus/PWR_3V3: R235.1; also elsewhere on the board
/Bus/PWR_5V: R236.1; also elsewhere on the board
/Bus/PWR_24V: R237.1; also elsewhere on the board
/Bus/SCLK: R214.1; also elsewhere on the board
/Bus/UART0_RXD: R222.1; also elsewhere on the board
/Bus/UART0_TXD: R221.1; also elsewhere on the board
GND: C201.2, C202.2, C203.2, C204.2, C205.2, C206.2, C207.2, C208.2, C209.2, C210.2, C211.2, C212.2, J201.A27 (27A), J201.A28 (28A), J201.A29 (29A), J201.A30 (30A), J201.A31 (31A), J201.A32 (32A), J201.B27 (27B), J201.B28 (28B), J201.B29 (29B), J201.B30 (30B), J201.B31 (31B), J201.B32 (32B); also elsewhere on the board
unnamed: C201.1, C202.1, C203.1, C204.1, C205.1, C206.1, J201.A1 (1A), J201.A2 (2A), J201.B1 (1B), J201.B2 (2B), L201.1
unnamed: J201.A5 (5A), R201.2
unnamed: J201.A6 (6A), R203.2
unnamed: J201.A7 (7A), R205.2
unnamed: J201.A8 (8A), R207.2
unnamed: J201.A9 (9A), R209.2
unnamed: J201.A10 (10A), R211.2
unnamed: J201.A11 (11A), R213.2
unnamed: J201.A12 (12A), R215.2
unnamed: J201.A13 (13A), R217.2
unnamed: J201.A14 (14A), R219.2
unnamed: J201.A15 (15A), R221.2
unnamed: J201.A16 (16A), R223.2
unnamed: J201.A17 (17A), R225.2
unnamed: J201.A18 (18A), R227.2
unnamed: J201.A19 (19A), R229.2
unnamed: J201.A20 (20A), R231.2
unnamed: J201.A21 (21A), R233.2
unnamed: J201.A22 (22A), R235.2
unnamed: J201.B5 (5B), R202.2
unnamed: J201.B6 (6B), R204.2
unnamed: J201.B7 (7B), R206.2
unnamed: J201.B8 (8B), R208.2
unnamed: J201.B9 (9B), R210.2
unnamed: J201.B10 (10B), R212.2
unnamed: J201.B11 (11B), R214.2
unnamed: J201.B12 (12B), R216.2
unnamed: J201.B13 (13B), R218.2
unnamed: J201.B14 (14B), R220.2
unnamed: J201.B15 (15B), R222.2
unnamed: J201.B16 (16B), R224.2
unnamed: J201.B17 (17B), R226.2
unnamed: J201.B18 (18B), R228.2
unnamed: J201.B19 (19B), R230.2
unnamed: J201.B20 (20B), R232.2
unnamed: J201.B21 (21B), R234.2
unnamed: J201.B22 (22B), R236.2
unnamed: J201.B23 (23B), R237.2
VDC: J201.A25 (25A), J201.A26 (26A), J201.B25 (25B), J201.B26 (26B)

Notes on the sheet:
Digital supply
CPU supply

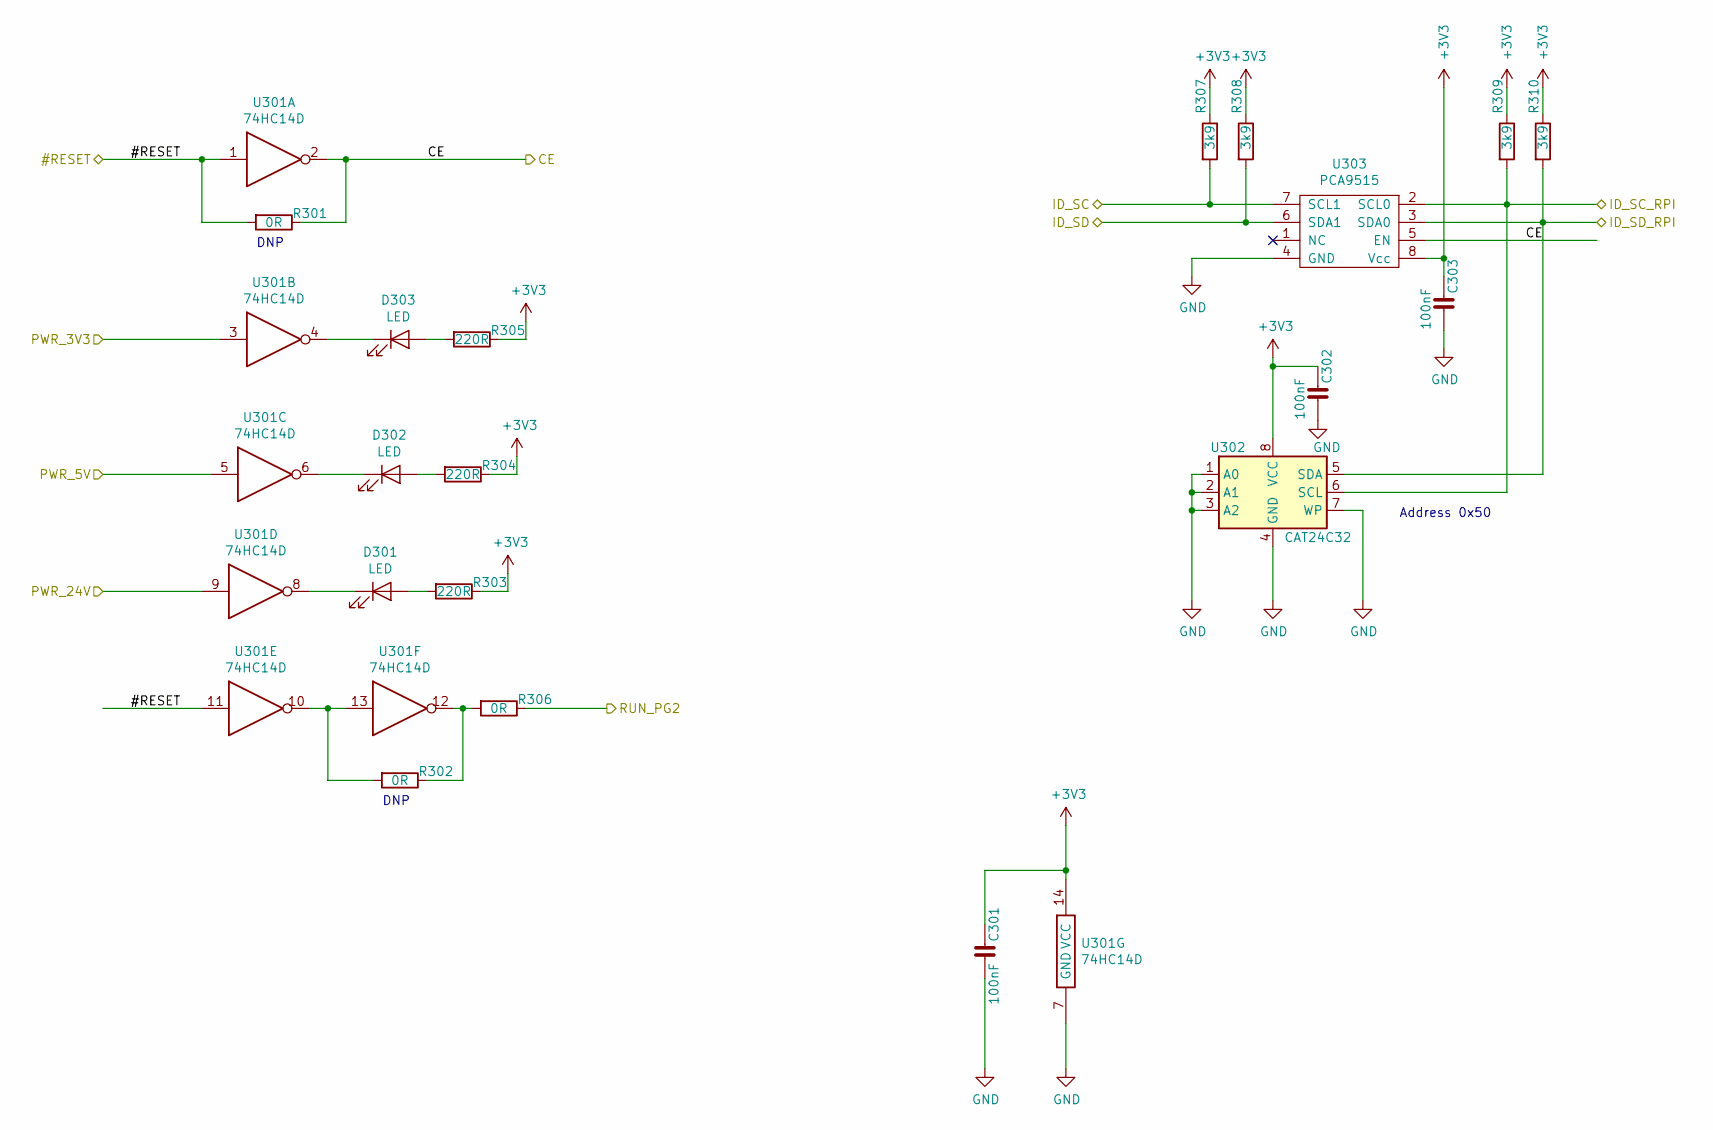
[picture p19: schematic Peripheral.sch, HEMAC MCU]

Parts:
C301, C302, C303: 100nF; C_0805
D301, D302, D303: LED; LED_D3.0mm
R301, R302, R306: 0R; R_0805
R303, R304, R305: 220R; R_0805
R307, R308, R309, R310: 3k9; R_0805
U301: 74HC14D; SOIC-14_3.9x8.7mm_P1.27mm
U302: CAT24C32; SOIC-8_3.9x4.9mm_P1.27mm
U303: PCA9515; SOIC-8_3.9x4.9mm_P1.27mm

Connections:
+3V3: C301.1, C302.1, C303.1, R303.1, R304.1, R305.1, R307.1, R308.1, R309.1, R310.1, U301.14 (VCC), U302.8 (VCC), U303.8 (Vcc); also elsewhere on the board
/Bus/#RESET: R301.2, U301.1, U301.11; also elsewhere on the board
/Bus/ID_SC: R307.2, U303.7 (SCL1); also elsewhere on the board
/Bus/ID_SD: R308.2, U303.6 (SDA1); also elsewhere on the board
/Bus/PWR_3V3: U301.3; also elsewhere on the board
/Bus/PWR_5V: U301.5; also elsewhere on the board
/Bus/PWR_24V: U301.9; also elsewhere on the board
/Computer/ID_SC_RPI: R309.2, U302.6 (SCL), U303.2 (SCL0); also elsewhere on the board
/Computer/ID_SD_RPI: R310.2, U302.5 (SDA), U303.3 (SDA0); also elsewhere on the board
/Computer/RUN_PG2: R306.1; also elsewhere on the board
/Inputs/CE: R301.1, U301.2, U303.5 (EN); also elsewhere on the board
GND: C301.2, C302.2, C303.2, U301.7 (GND), U302.1 (A0), U302.2 (A1), U302.3 (A2), U302.4 (GND), U302.7 (WP), U303.4 (GND); also elsewhere on the board
unnamed: D301.1 (K), U301.8
unnamed: D301.2 (A), R303.2
unnamed: D302.1 (K), U301.6
unnamed: D302.2 (A), R304.2
unnamed: D303.1 (K), U301.4
unnamed: D303.2 (A), R305.2
unnamed: R302.1, R306.2, U301.12
unnamed: R302.2, U301.10, U301.13

Notes on the sheet:
DNP
Address 0x50

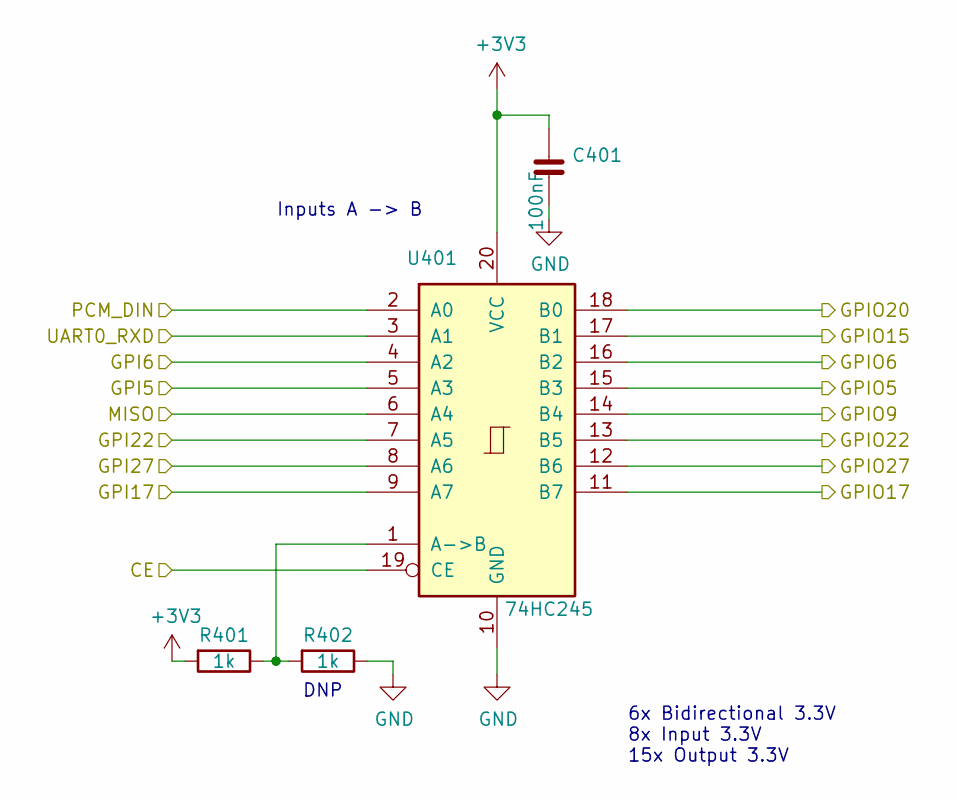
[picture p20: schematic Inputs.sch, HEMAC MCU]

Parts:
C401: 100nF; C_0805
R401, R402: 1k; R_0805
U401: 74HC245; SOIC-20W_7.5x12.8mm_P1.27mm

Connections:
+3V3: C401.1, R401.2, U401.20 (VCC); also elsewhere on the board
/Bus/GPI5: U401.5 (A3); also elsewhere on the board
/Bus/GPI6: U401.4 (A2); also elsewhere on the board
/Bus/GPI17: U401.9 (A7); also elsewhere on the board
/Bus/GPI22: U401.7 (A5); also elsewhere on the board
/Bus/GPI27: U401.8 (A6); also elsewhere on the board
/Bus/MISO: U401.6 (A4); also elsewhere on the board
/Bus/PCM_DIN: U401.2 (A0); also elsewhere on the board
/Bus/UART0_RXD: U401.3 (A1); also elsewhere on the board
/Computer/GPIO5: U401.15 (B3); also elsewhere on the board
/Computer/GPIO6: U401.16 (B2); also elsewhere on the board
/Computer/GPIO9: U401.14 (B4); also elsewhere on the board
/Computer/GPIO15: U401.17 (B1); also elsewhere on the board
/Computer/GPIO17: U401.11 (B7); also elsewhere on the board
/Computer/GPIO20: U401.18 (B0); also elsewhere on the board
/Computer/GPIO22: U401.13 (B5); also elsewhere on the board
/Computer/GPIO27: U401.12 (B6); also elsewhere on the board
/Inputs/CE: U401.19 (CE); also elsewhere on the board
GND: C401.2, R402.1, U401.10 (GND); also elsewhere on the board
unnamed: R401.1, R402.2, U401.1 (A->B)

Notes on the sheet:
6x Bidirectional 3.3V 8x Input 3.3V 15x Output 3.3V
Inputs A -> B
DNP
