Breschdling/HEMAC/MCU/HEMAC_MCU.kicad_pcb

## KiCad design MCU/HEMAC_MCU.kicad_pcb (continued)

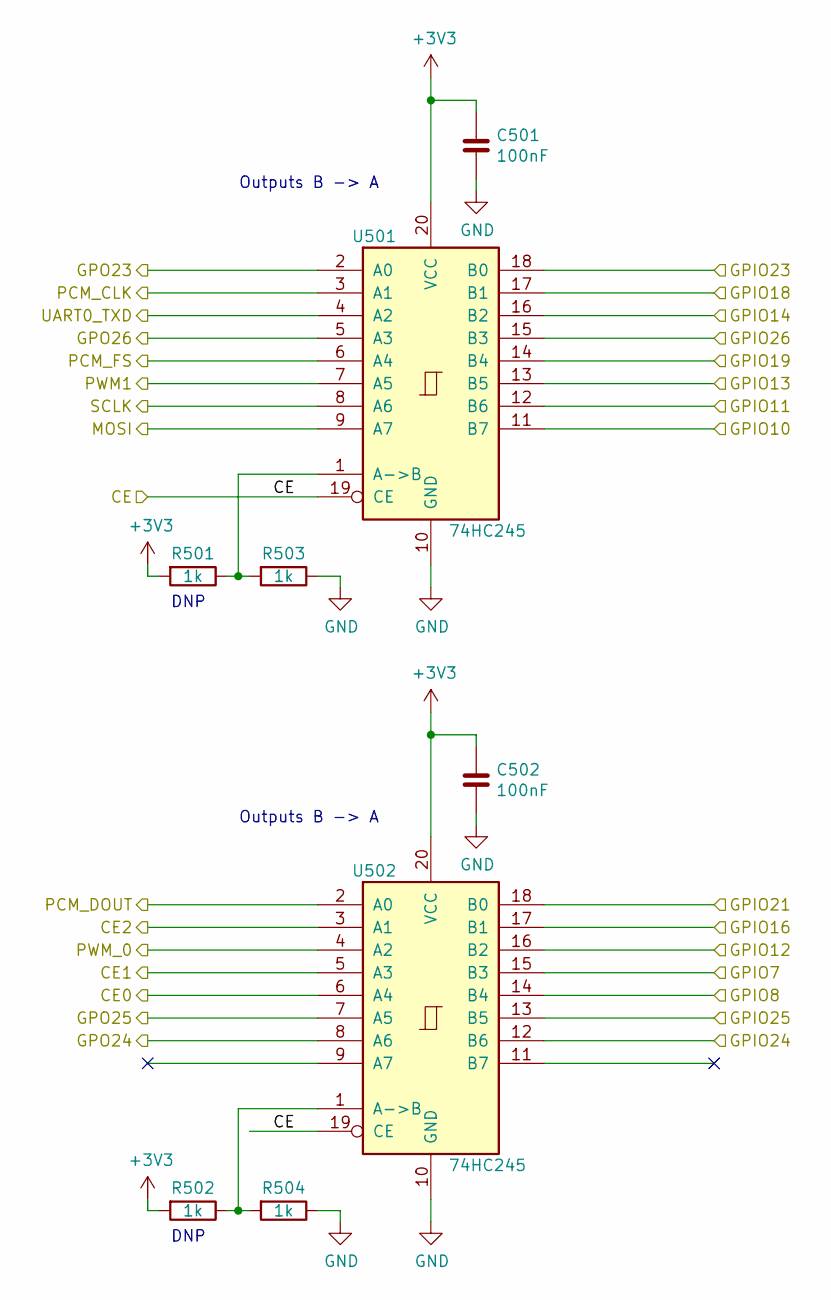
[picture p21: schematic Outputs.sch, HEMAC MCU]

Parts:
C501, C502: 100nF; C_0805
R501, R502, R503, R504: 1k; R_0805
U501, U502: 74HC245; SOIC-20W_7.5x12.8mm_P1.27mm

Connections:
+3V3: C501.1, C502.1, R501.2, R502.2, U501.20 (VCC), U502.20 (VCC); also elsewhere on the board
/Bus/CE0: U502.6 (A4); also elsewhere on the board
/Bus/CE1: U502.5 (A3); also elsewhere on the board
/Bus/CE2: U502.3 (A1); also elsewhere on the board
/Bus/GPO23: U501.2 (A0); also elsewhere on the board
/Bus/GPO24: U502.8 (A6); also elsewhere on the board
/Bus/GPO25: U502.7 (A5); also elsewhere on the board
/Bus/GPO26: U501.5 (A3); also elsewhere on the board
/Bus/MOSI: U501.9 (A7); also elsewhere on the board
/Bus/PCM_CLK: U501.3 (A1); also elsewhere on the board
/Bus/PCM_DOUT: U502.2 (A0); also elsewhere on the board
/Bus/PCM_FS: U501.6 (A4); also elsewhere on the board
/Bus/PWM0: U502.4 (A2); also elsewhere on the board
/Bus/PWM1: U501.7 (A5); also elsewhere on the board
/Bus/SCLK: U501.8 (A6); also elsewhere on the board
/Bus/UART0_TXD: U501.4 (A2); also elsewhere on the board
/Computer/GPIO7: U502.15 (B3); also elsewhere on the board
/Computer/GPIO8: U502.14 (B4); also elsewhere on the board
/Computer/GPIO10: U501.11 (B7); also elsewhere on the board
/Computer/GPIO11: U501.12 (B6); also elsewhere on the board
/Computer/GPIO12: U502.16 (B2); also elsewhere on the board
/Computer/GPIO13: U501.13 (B5); also elsewhere on the board
/Computer/GPIO14: U501.16 (B2); also elsewhere on the board
/Computer/GPIO16: U502.17 (B1); also elsewhere on the board
/Computer/GPIO18: U501.17 (B1); also elsewhere on the board
/Computer/GPIO19: U501.14 (B4); also elsewhere on the board
/Computer/GPIO21: U502.18 (B0); also elsewhere on the board
/Computer/GPIO23: U501.18 (B0); also elsewhere on the board
/Computer/GPIO24: U502.12 (B6); also elsewhere on the board
/Computer/GPIO25: U502.13 (B5); also elsewhere on the board
/Computer/GPIO26: U501.15 (B3); also elsewhere on the board
/Inputs/CE: U501.19 (CE), U502.19 (CE); also elsewhere on the board
GND: C501.2, C502.2, R503.1, R504.1, U501.10 (GND), U502.10 (GND); also elsewhere on the board
unnamed: R501.1, R503.2, U501.1 (A->B)
unnamed: R502.1, R504.2, U502.1 (A->B)

Notes on the sheet:
Outputs B -> A
DNP

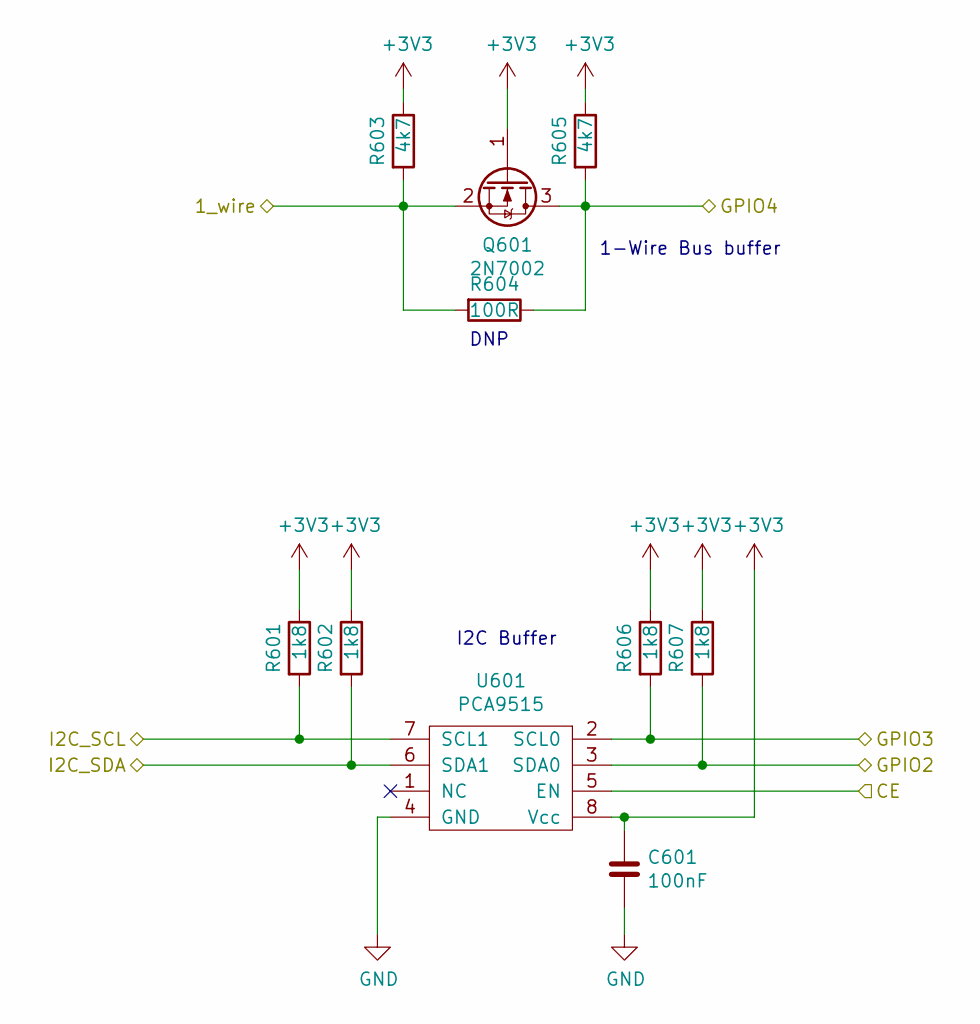
[picture p22: schematic Serial.sch, HEMAC MCU]

Parts:
C601: 100nF; C_0805
Q601: 2N7002; SOT-23
R601, R602, R606, R607: 1k8; R_0805
R603, R605: 4k7; R_0805
R604: 100R; R_0805
U601: PCA9515; SOIC-8_3.9x4.9mm_P1.27mm

Connections:
+3V3: C601.1, Q601.1 (G), R601.1, R602.1, R603.1, R605.1, R606.1, R607.1, U601.8 (Vcc); also elsewhere on the board
/Bus/1_wire: Q601.2 (S), R603.2, R604.2; also elsewhere on the board
/Bus/I2C_SCL: R601.2, U601.7 (SCL1); also elsewhere on the board
/Bus/I2C_SDA: R602.2, U601.6 (SDA1); also elsewhere on the board
/Computer/GPIO2: R607.2, U601.3 (SDA0); also elsewhere on the board
/Computer/GPIO3: R606.2, U601.2 (SCL0); also elsewhere on the board
/Computer/GPIO4: Q601.3 (D), R604.1, R605.2; also elsewhere on the board
/Inputs/CE: U601.5 (EN); also elsewhere on the board
GND: C601.2, U601.4 (GND); also elsewhere on the board

Notes on the sheet:
DNP
1-Wire Bus buffer
I2C Buffer

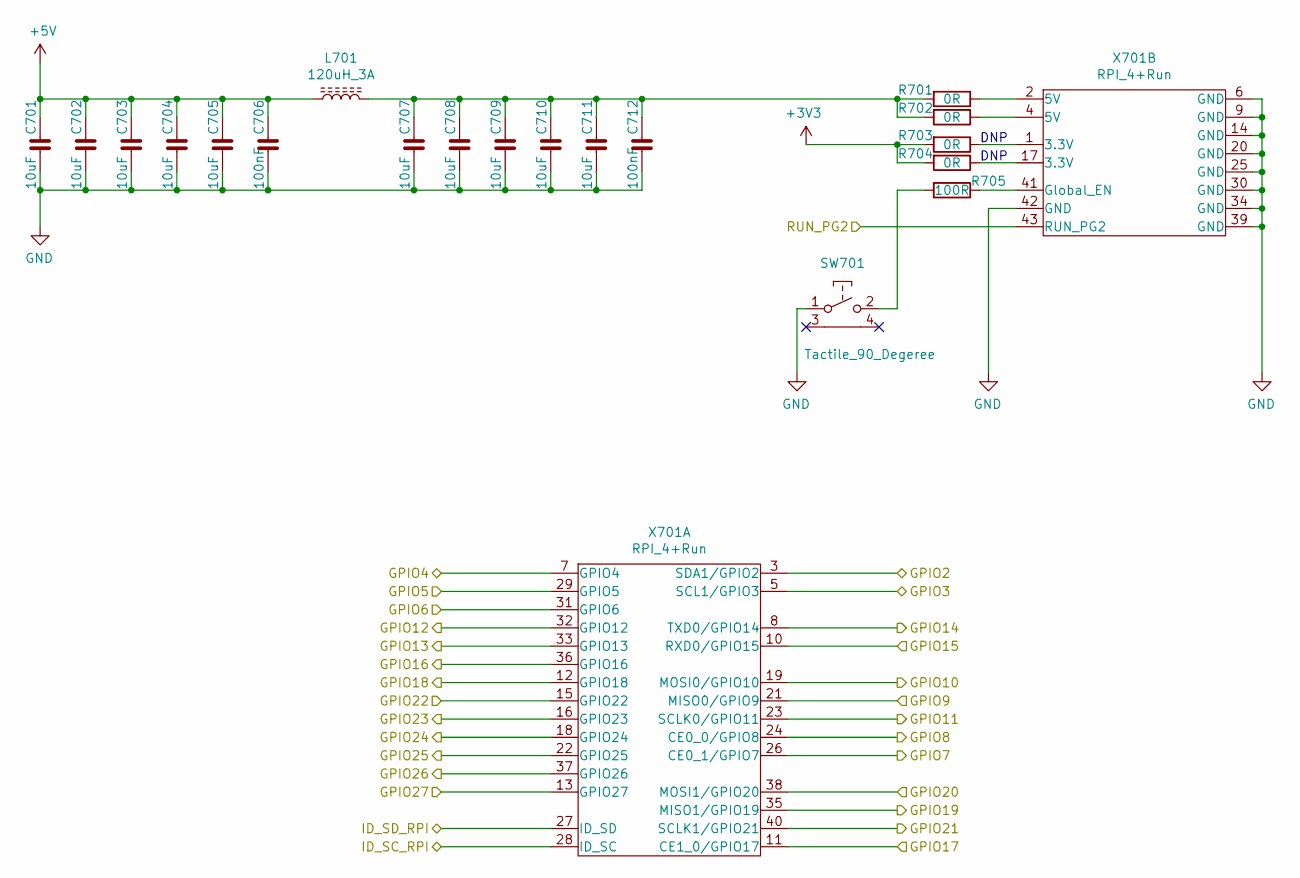
[picture p23: schematic Computer.sch, HEMAC MCU]

Parts:
C701, C702, C703, C704, C705, C707, C708, C709, C710, C711: 10uF; C_0805
C706, C712: 100nF; C_0805
L701: 120uH_3A; 16mm_Radial
R701, R702, R703, R704: 0R; R_1210
R705: 100R; R_0805
SW701: Tactile_90_Degeree; SW_Tactile_SPST_Angled_PTS645Vx58-2LFS
X701: RPI_4+Run; raspberrypi4

Connections:
+3V3: R703.2, R704.2; also elsewhere on the board
+5V: C701.1, C702.1, C703.1, C704.1, C705.1, C706.1, L701.2; also elsewhere on the board
/Computer/GPIO2: X701.3 (SDA1/GPIO2); also elsewhere on the board
/Computer/GPIO3: X701.5 (SCL1/GPIO3); also elsewhere on the board
/Computer/GPIO4: X701.7 (GPIO4); also elsewhere on the board
/Computer/GPIO5: X701.29 (GPIO5); also elsewhere on the board
/Computer/GPIO6: X701.31 (GPIO6); also elsewhere on the board
/Computer/GPIO7: X701.26 (CE0_1/GPIO7); also elsewhere on the board
/Computer/GPIO8: X701.24 (CE0_0/GPIO8); also elsewhere on the board
/Computer/GPIO9: X701.21 (MISO0/GPIO9); also elsewhere on the board
/Computer/GPIO10: X701.19 (MOSI0/GPIO10); also elsewhere on the board
/Computer/GPIO11: X701.23 (SCLK0/GPIO11); also elsewhere on the board
/Computer/GPIO12: X701.32 (GPIO12); also elsewhere on the board
/Computer/GPIO13: X701.33 (GPIO13); also elsewhere on the board
/Computer/GPIO14: X701.8 (TXD0/GPIO14); also elsewhere on the board
/Computer/GPIO15: X701.10 (RXD0/GPIO15); also elsewhere on the board
/Computer/GPIO16: X701.36 (GPIO16); also elsewhere on the board
/Computer/GPIO17: X701.11 (CE1_0/GPIO17); also elsewhere on the board
/Computer/GPIO18: X701.12 (GPIO18); also elsewhere on the board
/Computer/GPIO19: X701.35 (MISO1/GPIO19); also elsewhere on the board
/Computer/GPIO20: X701.38 (MOSI1/GPIO20); also elsewhere on the board
/Computer/GPIO21: X701.40 (SCLK1/GPIO21); also elsewhere on the board
/Computer/GPIO22: X701.15 (GPIO22); also elsewhere on the board
/Computer/GPIO23: X701.16 (GPIO23); also elsewhere on the board
/Computer/GPIO24: X701.18 (GPIO24); also elsewhere on the board
/Computer/GPIO25: X701.22 (GPIO25); also elsewhere on the board
/Computer/GPIO26: X701.37 (GPIO26); also elsewhere on the board
/Computer/GPIO27: X701.13 (GPIO27); also elsewhere on the board
/Computer/ID_SC_RPI: X701.28 (ID_SC); also elsewhere on the board
/Computer/ID_SD_RPI: X701.27 (ID_SD); also elsewhere on the board
/Computer/RUN_PG2: X701.43 (RUN_PG2); also elsewhere on the board
GND: C701.2, C702.2, C703.2, C704.2, C705.2, C706.2, C707.2, C708.2, C709.2, C710.2, C711.2, C712.2, SW701.1, X701.6 (GND), X701.9 (GND), X701.14 (GND), X701.20 (GND), X701.25 (GND), X701.30 (GND), X701.34 (GND), X701.39 (GND), X701.42 (GND); also elsewhere on the board
unnamed: C707.1, C708.1, C709.1, C710.1, C711.1, C712.1, L701.1, R701.2, R702.2
unnamed: R701.1, X701.2 (5V)
unnamed: R702.1, X701.4 (5V)
unnamed: R703.1, X701.1 (3.3V)
unnamed: R704.1, X701.17 (3.3V)
unnamed: R705.1, X701.41 (Global_EN)
unnamed: R705.2, SW701.2

Notes on the sheet:
DNP

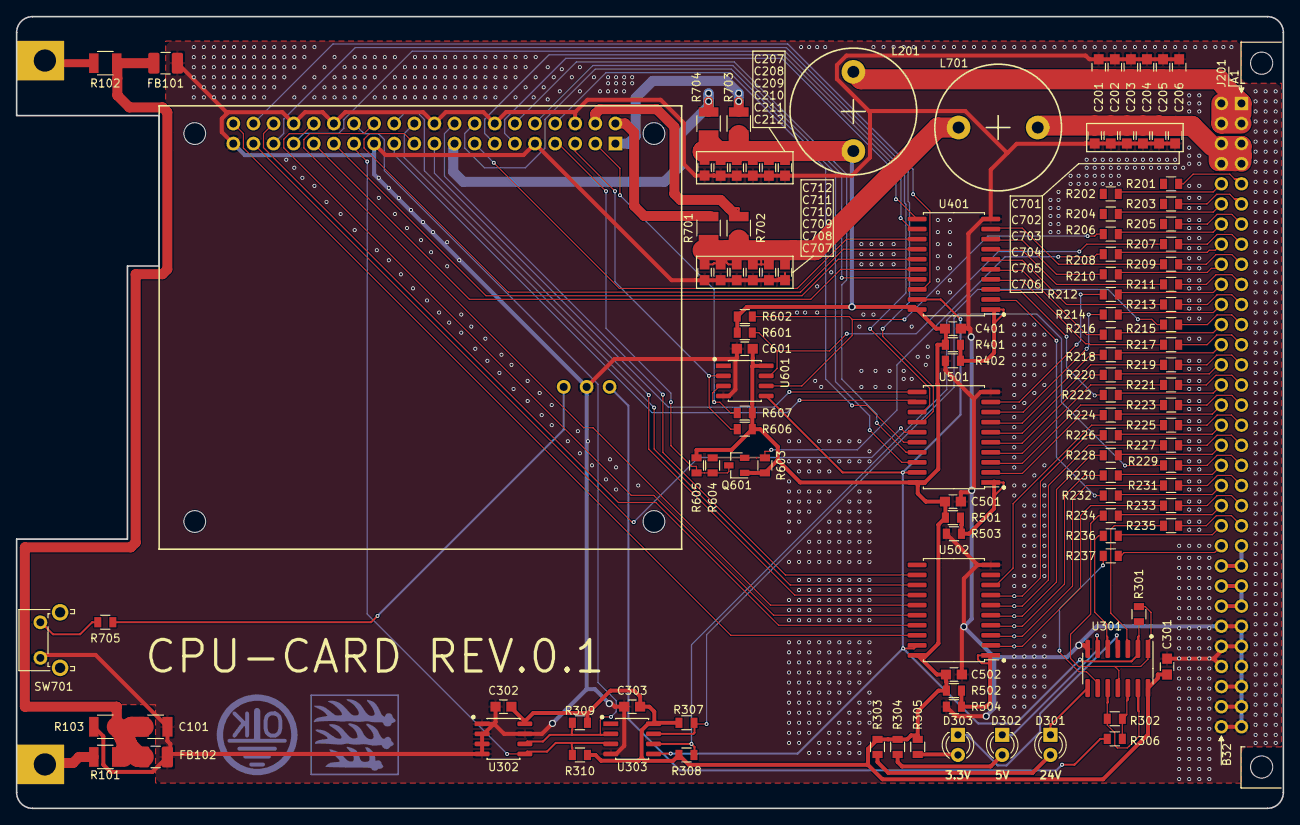
[picture p24: board HEMAC_MCU.kicad_pcb from above]

Board: 2 copper layers, 160.0 x 100.0 mm, 119 parts (0 on the bottom side), 126 nets.
