Breschdling/HEMAC/Power/HEMAC_POWER.kicad_pcb

## KiCad design Power/HEMAC_POWER.kicad_pcb (2023-01-20)

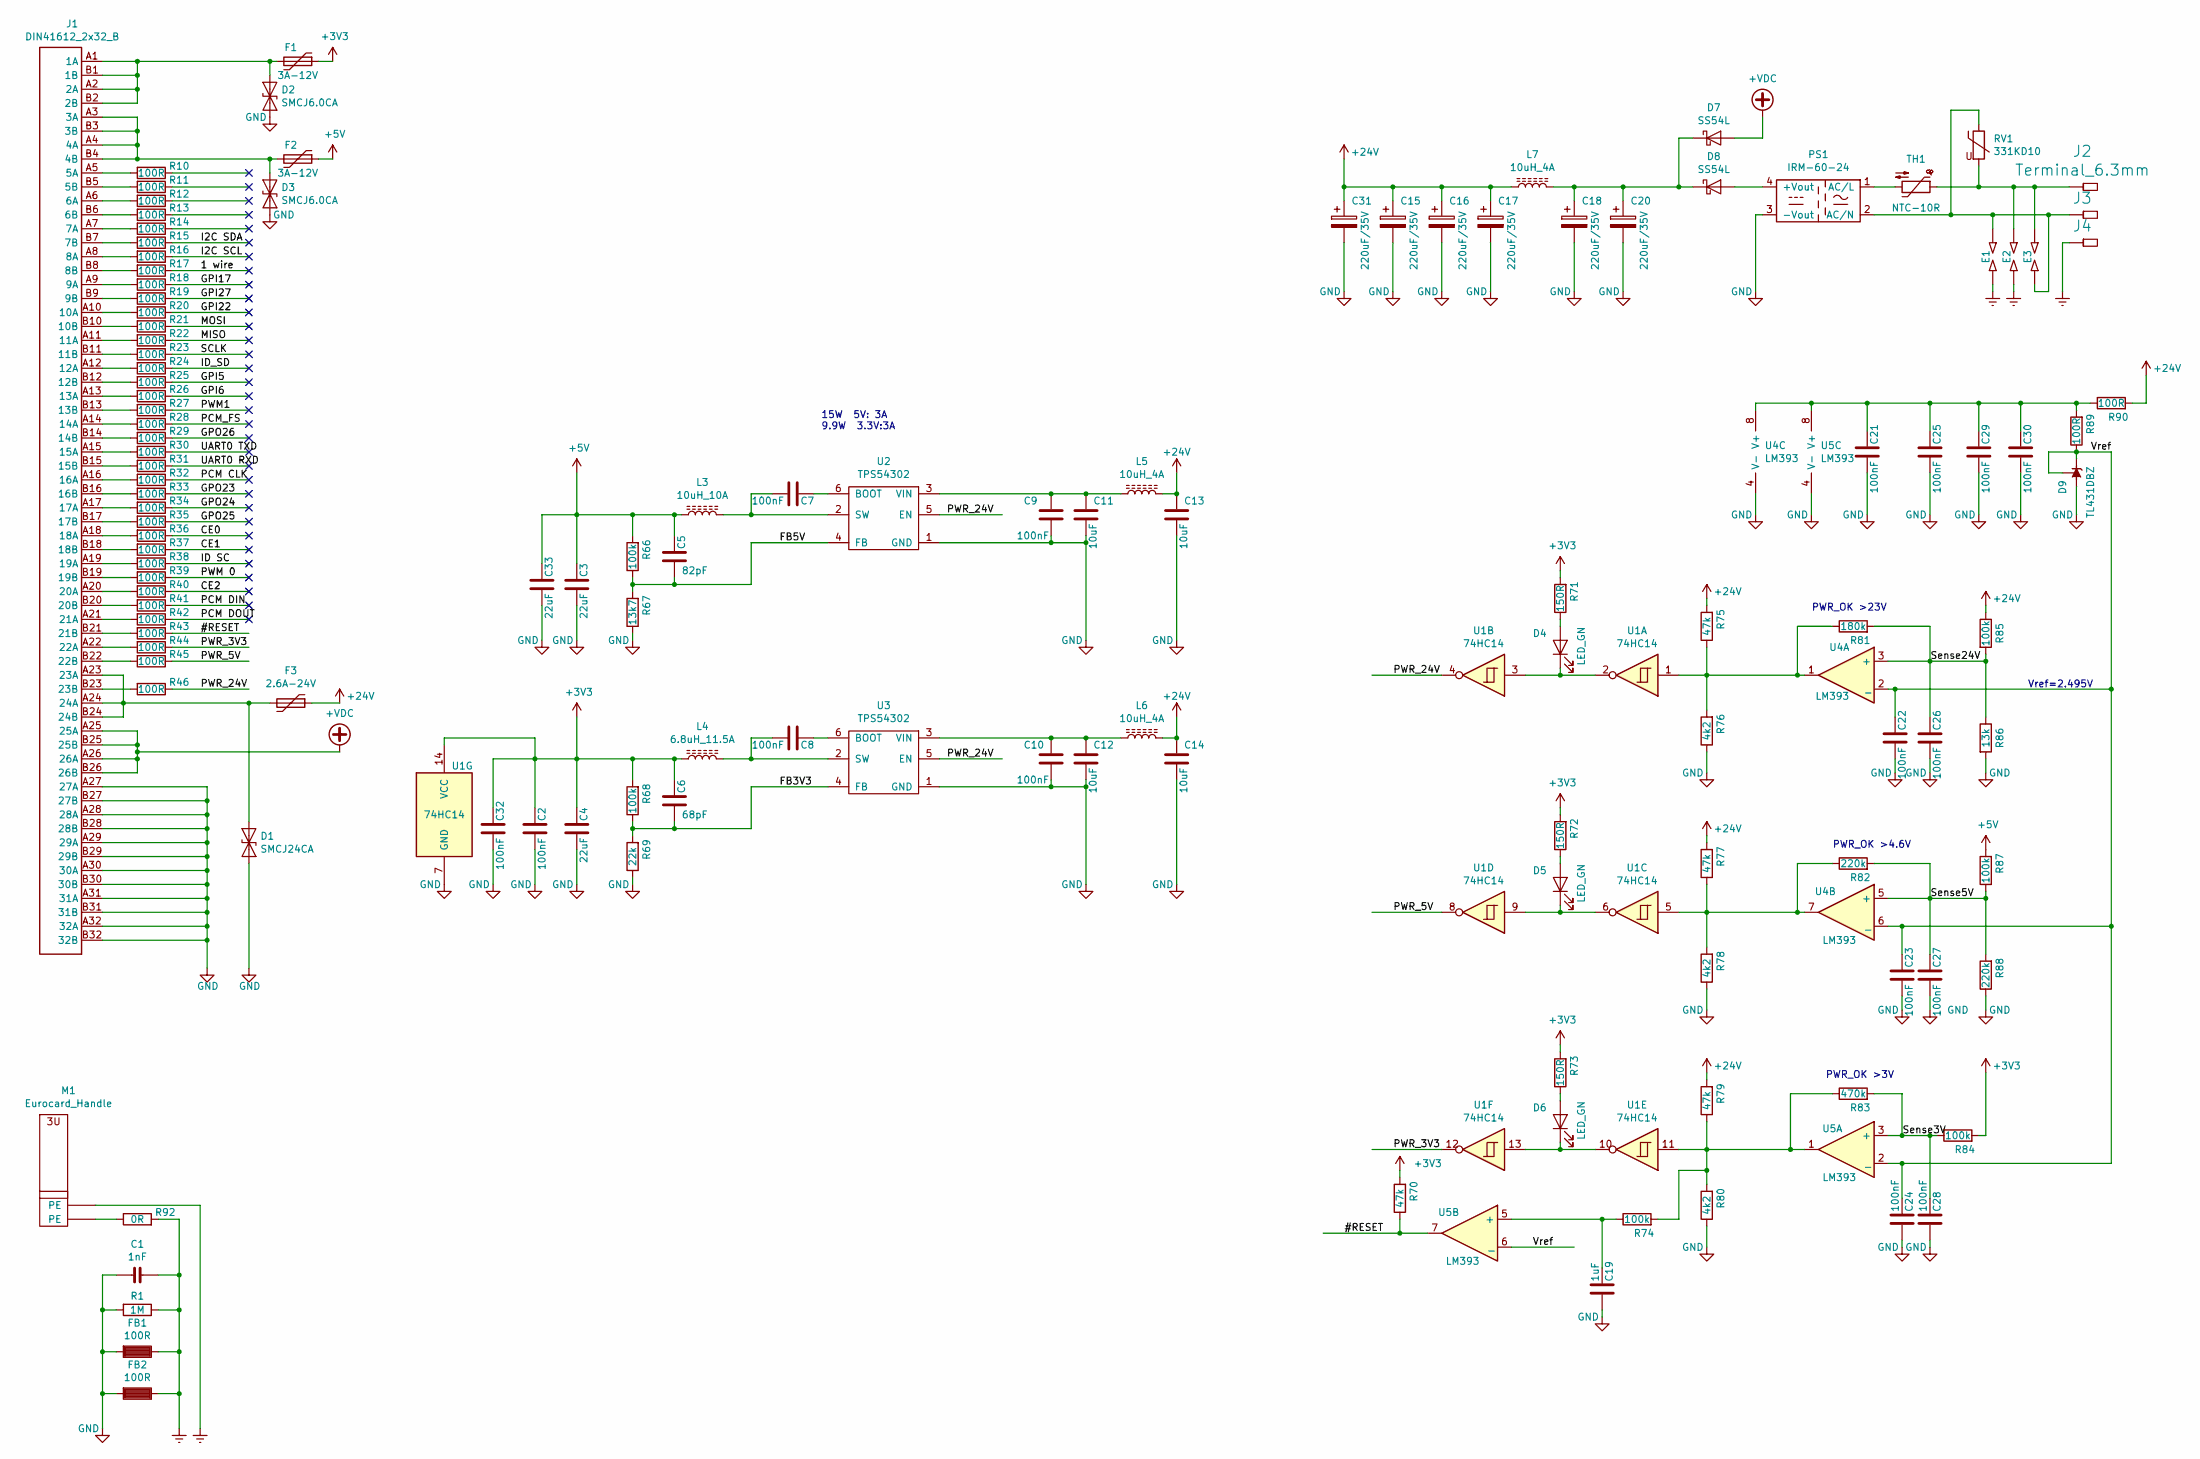
[picture p25: schematic HEMAC_POWER.sch, HEMAC Power]

Parts:
C1: 1nF; C_1210_3225Metric_Pad1.42x2.65mm_HandSolder
C2, C7, C8, C9, C10, C21, C22, C23, C24, C25, C26, C27, C28, C29, C30: 100nF; C_0805_HandSoldering
C3, C4: 22uF; C_0805_HandSoldering
C5: 82pF; C_0805_HandSoldering
C6: 68pF; C_0805_HandSoldering
C11, C12, C13, C14: 10uF; C_0805_HandSoldering
C15, C16, C17, C18, C20, C31: 220uF/35V; CP_Radial_D8.0mm_P3.50mm
C19: 1uF; C_0805_HandSoldering
C32: 100nF; C_0805_2012Metric_Pad1.15x1.40mm_HandSolder
C33: 22uF; C_0805_2012Metric_Pad1.15x1.40mm_HandSolder
D1: SMCJ24CA; D_SMC
D2, D3: SMCJ6.0CA; D_SMC
D4, D5, D6: LED_GN; LED_D3.0mm
D7, D8: SS54L; D_SMC_Handsoldering
D9: TL431DBZ; SOT-23
E1, E2, E3: SPARK_GAP_0.5mm; SparkGap_0.5
F1, F2: 3A-12V; Fuse_SMD2920
F3: 2.6A-24V; Fuse_SMD2920
FB1, FB2: 100R; FB_1210_3225Metric_Pad1.42x2.65mm_HandSolder
J1: DIN41612_2x32_B; DIN41612_B_2x32_Horizontal
J2, J3, J4: Terminal_6.3mm; Terminal_6.3mm_THT
L3: 10uH_10A; Inductor_13.5x12.5
L4: 6.8uH_11.5A; Inductor_13.5x12.5
L5, L6, L7: 10uH_4A; Inductor_7.1x6.6
M1: Eurocard_Handle; EuroCard_Handle
PS1: IRM-60-24; IRM-60
R1: 1M; R_1210_3225Metric_Pad1.42x2.65mm_HandSolder
R10, R11, R12, R13, R14, R15, R16, R17, R18, R19, R20, R21, R22, R23, R24, R25, R26, R27, R28, R29, R30, R31, R32, R33, R34, R35, R36, R37, R38, R39, R40, R41, R42, R43, R44, R45, R46, R89, R90: 100R; R_0805_HandSoldering
R66, R68, R74, R84, R85, R87: 100k; R_0805_HandSoldering
R67: 13k7; R_0805_HandSoldering
R69: 22k; R_0805_HandSoldering
R70, R75, R77, R79: 47k; R_0805_HandSoldering
R71, R72, R73: 150R; R_0805_HandSoldering
R76, R78, R80: 4k2; R_0805_HandSoldering
R81: 180k; R_0805_HandSoldering
R82, R88: 220k; R_0805_HandSoldering
R83: 470k; R_0805_HandSoldering
R86: 13k; R_0805_HandSoldering
R92: 0R; R_1812_HandSoldering
RV1: 331KD10; D12mm_W5.4mm_P7.5mm
TH1: NTC-10R; RV_Disc_D12_W3.9_P7.5
U1: 74HC14; SOIC-14_3.9x8.7mm_Pitch1.27mm
U2, U3: TPS54302; SOT-23-6_Handsoldering
U4, U5: LM393; SOIC-8_3.9x4.9mm_Pitch1.27mm

Connections:
+3V3: C2.1, C4.1, C6.1, C32.1, F1.1, L4.1, R68.2, R70.2, R71.2, R72.2, R73.2, R84.2, U1.14 (VCC)
+5V: C3.1, C5.1, C33.1, F2.1, L3.1, R66.2, R87.2
+24V: C13.1, C14.1, C15.1, C16.1, C17.1, C31.1, F3.1, L5.2, L6.2, L7.1, R75.2, R77.2, R79.2, R85.1, R90.2
/1 wire: R17.1
/#RESET: R43.1, R70.1, U5.7
/CE0: R36.1
/CE1: R37.1
/CE2: R40.1
/FB3V3: C6.2, R68.1, R69.2, U3.4 (FB)
/FB5V: C5.2, R66.1, R67.2, U2.4 (FB)
/GPI5: R25.1
/GPI6: R26.1
/GPI17: R18.1
/GPI22: R20.1
/GPI27: R19.1
/GPO23: R33.1
/GPO24: R34.1
/GPO25: R35.1
/GPO26: R29.1
/I2C SCL: R16.1
/I2C SDA: R15.1
/ID SC: R38.1
/ID_SD: R24.1
/MISO: R22.1
/MOSI: R21.1
/PCM CLK: R32.1
/PCM DIN: R41.1
/PCM DOUT: R42.1
/PCM_FS: R28.1
/PWM1: R27.1
/PWM 0: R39.1
/PWR_3V3: R44.1, U1.12
/PWR_5V: R45.1, U1.8
/PWR_24V: R46.1, U1.4, U2.5 (EN), U3.5 (EN)
/SCLK: R23.1
/Sense3V: C28.1, R83.2, R84.1, U5.3 (+)
/Sense5V: C27.1, R82.2, R87.1, R88.2, U4.5 (+)
/Sense24V: C26.1, R81.2, R85.2, R86.1, U4.3 (+)
/UART0 RXD: R31.1
/UART0 TXD: R30.1
/Vref: C22.1, C23.1, C24.1, D9.1 (K), D9.2 (REF), R89.1, U4.2 (_), U4.6 (_), U5.2 (_), U5.6 (_)
Earth: C1.1, E1.2, E2.2, FB1.1, FB2.1, J4.1, M1.1, R1.1, R92.2
GND: C1.2, C2.2, C3.2, C4.2, C9.2, C10.2, C11.2, C12.2, C13.2, C14.2, C15.2, C16.2, C17.2, C18.2, C19.2, C20.2, C21.2, C22.2, C23.2, C24.2, C25.2, C26.2, C27.2, C28.2, C29.2, C30.2, C31.2, C32.2, C33.2, D1.2 (A2), D2.2 (A2), D3.2 (A2), D9.3 (A), FB1.2, FB2.2, J1.A27 (27A), J1.A28 (28A), J1.A29 (29A), J1.A30 (30A), J1.A31 (31A), J1.A32 (32A), J1.B27 (27B), J1.B28 (28B), J1.B29 (29B), J1.B30 (30B), J1.B31 (31B), J1.B32 (32B), PS1.3 (-Vout), R1.2, R67.1, R69.1, R76.1, R78.1, R80.1, R86.2, R88.1, U1.7 (GND), U2.1 (GND), U3.1 (GND), U4.4 (V-), U5.4 (V-)
unnamed: C7.1, U2.6 (BOOT)
unnamed: C7.2, L3.2, U2.2 (SW)
unnamed: C8.1, U3.6 (BOOT)
unnamed: C8.2, L4.2, U3.2 (SW)
unnamed: C10.1, C12.1, L6.1, U3.3 (VIN)
unnamed: C9.1, C11.1, L5.1, U2.3 (VIN)
unnamed: C18.1, C20.1, D7.1 (K), D8.1 (K), L7.2
unnamed: C19.1, R74.1, U5.5 (+)
unnamed: C21.1, C25.1, C29.1, C30.1, R89.2, R90.1, U4.8 (V+), U5.8 (V+)
unnamed: D1.1 (A1), F3.2, J1.A23 (23A), J1.A24 (24A), J1.B24 (24B)
unnamed: D2.1 (A1), F1.2, J1.A1 (1A), J1.A2 (2A), J1.B1 (1B), J1.B2 (2B)
unnamed: D3.1 (A1), F2.2, J1.A3 (3A), J1.A4 (4A), J1.B3 (3B), J1.B4 (4B)
unnamed: D4.1 (K), U1.2, U1.3
unnamed: D4.2 (A), R71.1
unnamed: D5.1 (K), U1.6, U1.9
unnamed: D5.2 (A), R72.1
unnamed: D6.1 (K), U1.10, U1.13
unnamed: D6.2 (A), R73.1
unnamed: D8.2 (A), PS1.4 (+Vout)
unnamed: E1.1, E3.2, J3.1, PS1.2 (AC/N), RV1.1
unnamed: E2.1, E3.1, J2.1, RV1.2, TH1.1
unnamed: J1.A5 (5A), R10.2
unnamed: J1.A6 (6A), R12.2
unnamed: J1.A7 (7A), R14.2
unnamed: J1.A8 (8A), R16.2
unnamed: J1.A9 (9A), R18.2
unnamed: J1.A10 (10A), R20.2
unnamed: J1.A11 (11A), R22.2
unnamed: J1.A12 (12A), R24.2
unnamed: J1.A13 (13A), R26.2
unnamed: J1.A14 (14A), R28.2
unnamed: J1.A15 (15A), R30.2
unnamed: J1.A16 (16A), R32.2
unnamed: J1.A17 (17A), R34.2
unnamed: J1.A18 (18A), R36.2
unnamed: J1.A19 (19A), R38.2
unnamed: J1.A20 (20A), R40.2
unnamed: J1.A21 (21A), R42.2
unnamed: J1.A22 (22A), R44.2
unnamed: J1.B5 (5B), R11.2
unnamed: J1.B6 (6B), R13.2
unnamed: J1.B7 (7B), R15.2
unnamed: J1.B8 (8B), R17.2
unnamed: J1.B9 (9B), R19.2
unnamed: J1.B10 (10B), R21.2
unnamed: J1.B11 (11B), R23.2
unnamed: J1.B12 (12B), R25.2
unnamed: J1.B13 (13B), R27.2
unnamed: J1.B14 (14B), R29.2
unnamed: J1.B15 (15B), R31.2
unnamed: J1.B16 (16B), R33.2
unnamed: J1.B17 (17B), R35.2
unnamed: J1.B18 (18B), R37.2
unnamed: J1.B19 (19B), R39.2
unnamed: J1.B20 (20B), R41.2
unnamed: J1.B21 (21B), R43.2
unnamed: J1.B22 (22B), R45.2
unnamed: J1.B23 (23B), R46.2
unnamed: M1.2, R92.1
unnamed: PS1.1 (AC/L), TH1.2
unnamed: R74.2, R79.1, R80.2, R83.1, U1.11, U5.1
unnamed: R75.1, R76.2, R81.1, U1.1, U4.1
unnamed: R77.1, R78.2, R82.1, U1.5, U4.7
VDC: D7.2 (A), J1.A25 (25A), J1.A26 (26A), J1.B25 (25B), J1.B26 (26B)

Notes on the sheet:
PWR_OK >23V
15W 5V: 3A 9.9W 3.3V:3A
PWR_OK >4.6V
PWR_OK >3V
Vref=2.495V

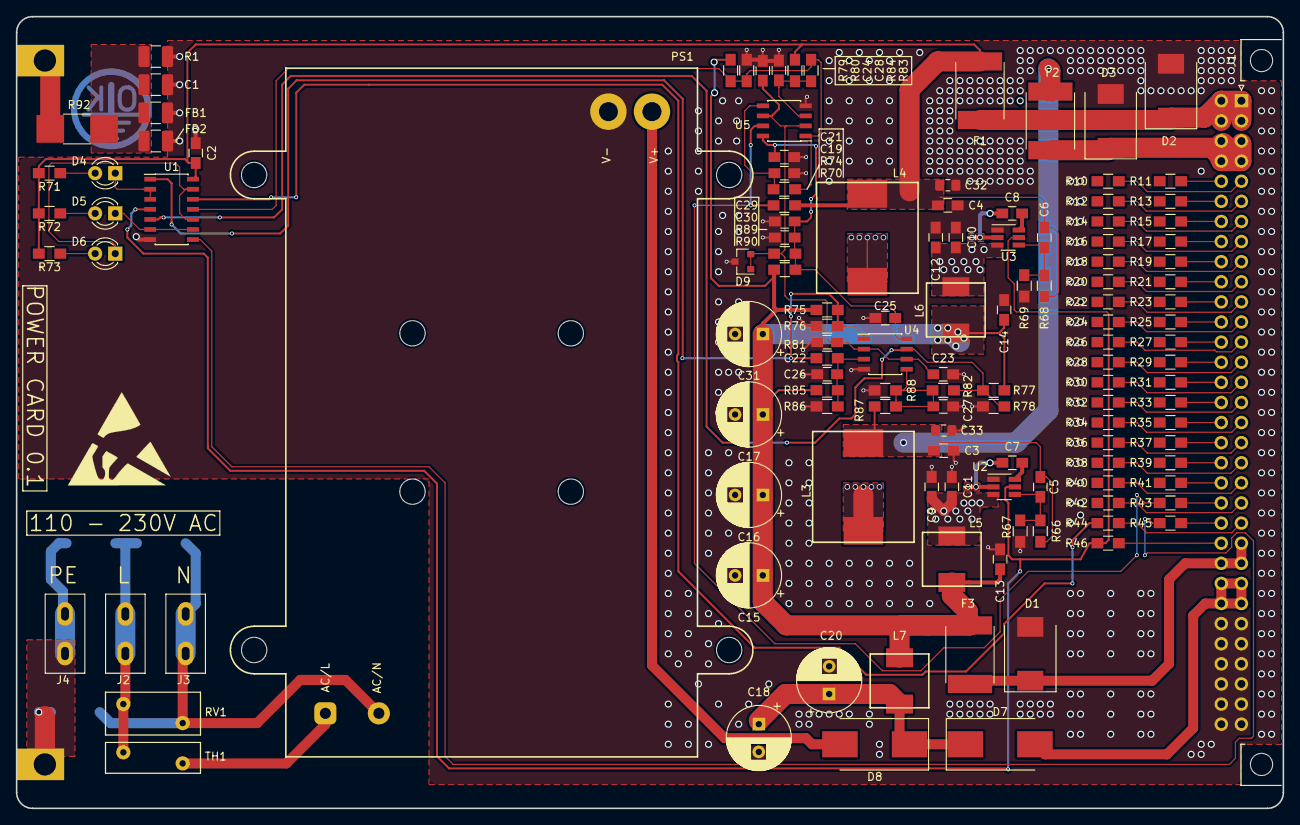
[picture p26: board HEMAC_POWER.kicad_pcb from above]

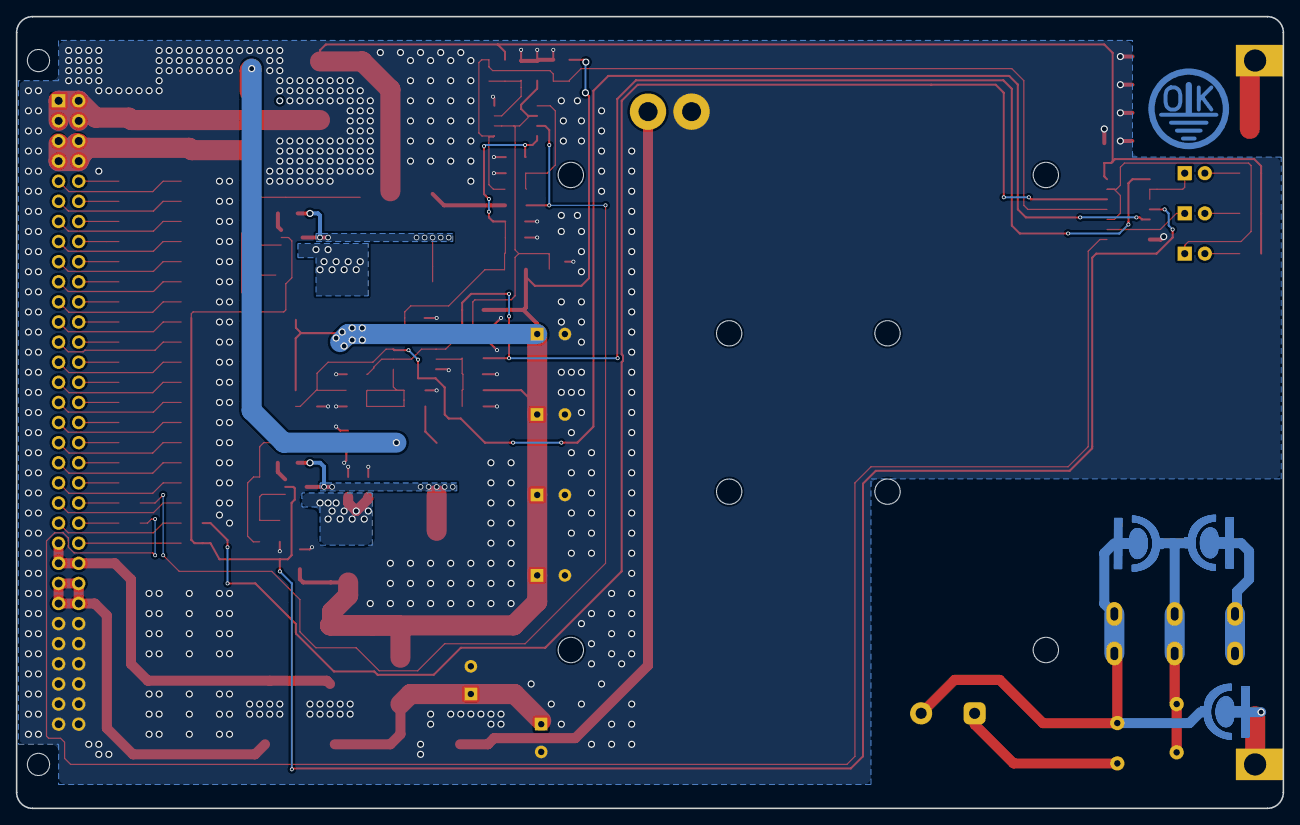
[picture p27: board HEMAC_POWER.kicad_pcb from below]

Board: 2 copper layers, 160.0 x 100.0 mm, 132 parts (3 on the bottom side), 79 nets.
